printo3d/Prusai3-Rework-Alu/prusai3al-instrukcja.pdf

Prusa i3 - Instrukcja Montażu

1

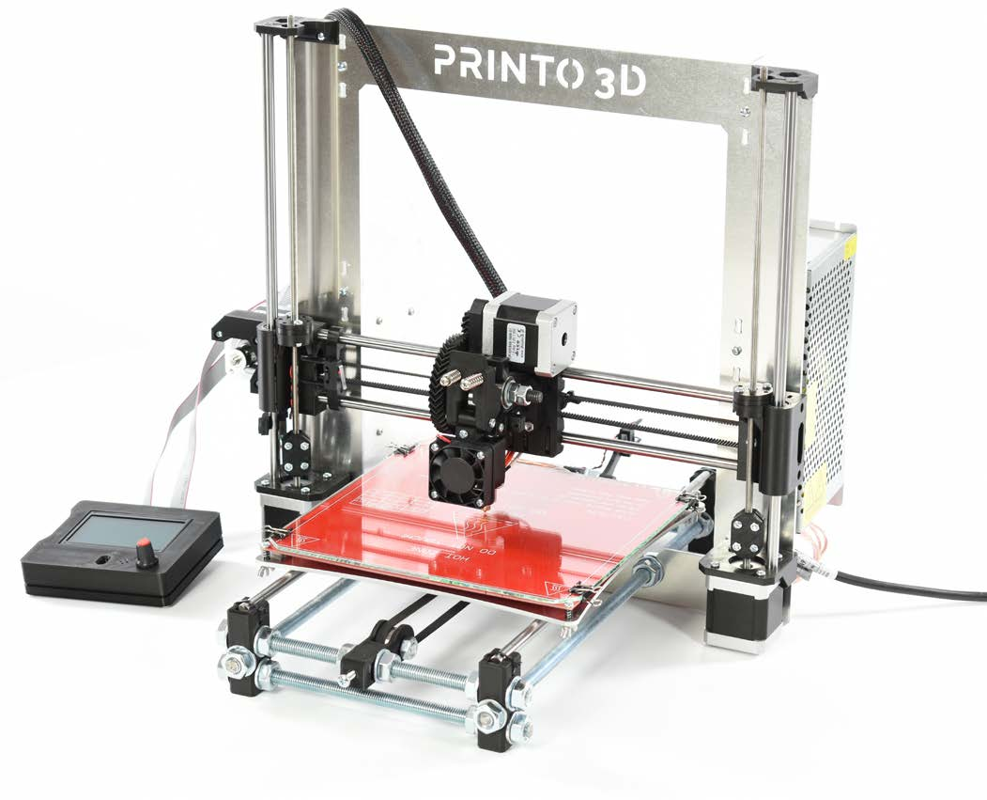
[picture p1: figure]

# Prusa i3

# INSTRUKCJA MONTAŻU DRUKARKI 3D

2

## Spis Treści I. Prusa i3 - Rzut ogólny

4

## II. Lista części

7
III. Montaż | 12
A. Monta
ż osi Y: | 12
1.
Stolik osi Y: | 12
2. Y
Idler | 13
3. Podstawa Y | 13
4.
Silnik osi Y | 16
5. P
asek osi Y | 19
B. Monta
ż osi X: | 22
1. Łoż
ysk

a liniowe - Xend

y | 22
2. Mocowani
a

n

akrętek M5 | 23
3.
K
aretk
a osi X | 24
4. Prowadnice liniowe X | 25
5.
Silnik osi X | 26
6. P
asek osi X | 27
C. Monta
ż

ramy druk

arki

: | 30

D.
O
ś Z | 31
1. Z
botto
m | 31
2. Łąc
zniki osi Z | 33
3. P
o

łąc

zenie osi X

z osią Z | 34
E. Łąc
znie
z osią Y | 37
E. Monta
ż ekstruder | 39
1.
Ekstruder | 39
2. G
łowic

a druk

arki | 40
3.
Went
y

l

ator ch

łod

ząc

y głowicę | 42
4.
Silnik ekstruder
a | 43
V. Elektronika | 47
A. P
rzygotowanie wią

zki
p

r

zewodów | 47
1. P
r

zewod

y silników (
t

ylko wersj

a Prus
a
i3 B) | 47
2. P
r

zewod

y kr

ańcówek (endsto

pów)
i głowic
y | 48
3. Monta
ż kr
ańcówek | 49
4. G
rzał

k

a sto
ł
u | 52
V. Przygotowanie Do Pracy | 59
A.
W
g

r
y

wanie Fir
m
ware | 59
B. P
o

zio

mowanie

Sto
ł
u | 60

3

# I Rzut Ogólny

4

## I. Prusa i3 - Rzut ogólny

Prusa i3 jest wersją otwartego projektu Prusa Mendel autorstwa Josefa Prusy. Wersja przedstawiona w tej instrukcji jest wersją lekko zmodyfikowaną nie odbiegającą jednak od fundamentalnych założeń projektu. Drukarka 3D oparta jest o konstrukcję z 3 mm aluminium, pręty gwintowane M10, prowadnice liniowe fi 8 hartowane indukcyjnie w tolerancji H6 oraz silniki krokowe w standardzie NEMA 17. Wszystkie komponenty użyte do budowy urządzenia są popularne i szeroko dostępne.

Poniższa ilustracja przedstawia kierunki osi XYZ na modelu drukarki 3D Prusa i3

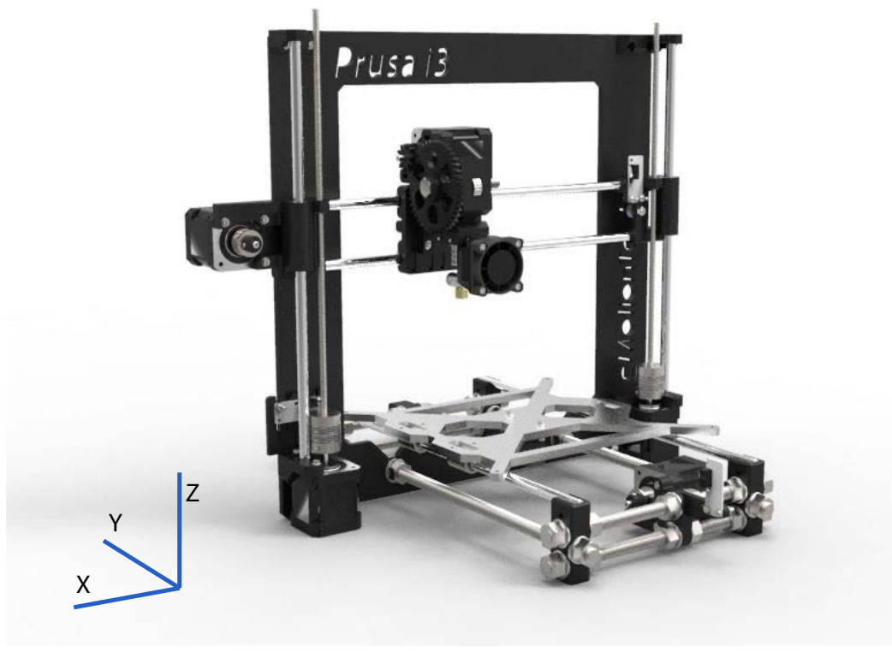
[picture p2: figure]

5

## Przydatne narzędzia

Poniżej lista kilku narzędzi przydatnych do montażu drukarki. Nie wszystkie są wymagane jednak posiadanie ich znacznie ułatwia i przyspiesza pracę nad urządzeniem. Większość z nich jest dostępna w każdym sklepie elektronicznym lub w sieci.
1. Klucze imbusowe
2. Śrubokręt/wkrętak
3. Klucz
4. Nożyk
5. Izolacja/rurki termokurczliwe
6. Multimeter - uniwersalny miernik elektroniczny
7. Lutownica
8. Olej maszynowy do prowadnic
9. Zaciskarka do pinów (budżetowe wersje Prusy i3)
10. Cążki do przewodów

6

# SKŁAD ZESTAWU II

## II. Lista części

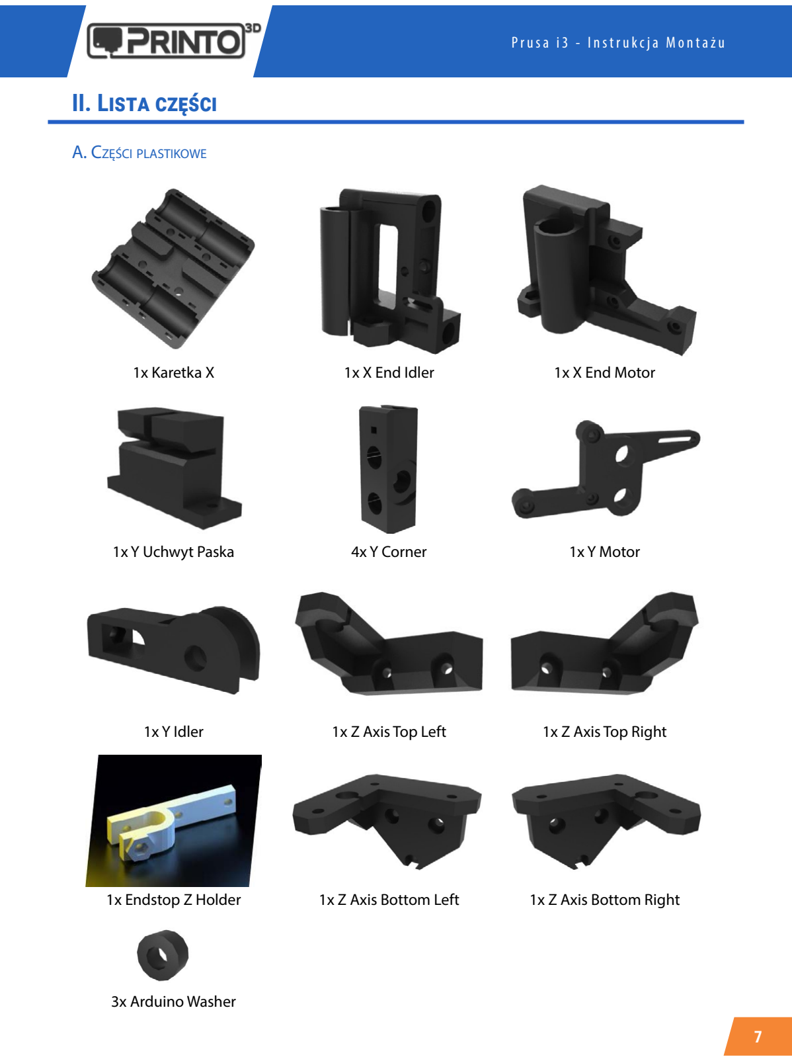
[picture p3: page 7]

7

1x Karetka X | 1x X End Idler | 1x X End Motor
1x Y Uchwyt Paska | 4x Y Corner | 1x Y Motor
1x Y Idler | 1x Z Axis Top Left | 1x Z Axis Top Right

3x Arduino Washer

1x Endstop Z Holder | 1x Z Axis Bottom Left | 1x Z Axis Bottom Right
A. Części plastikowe

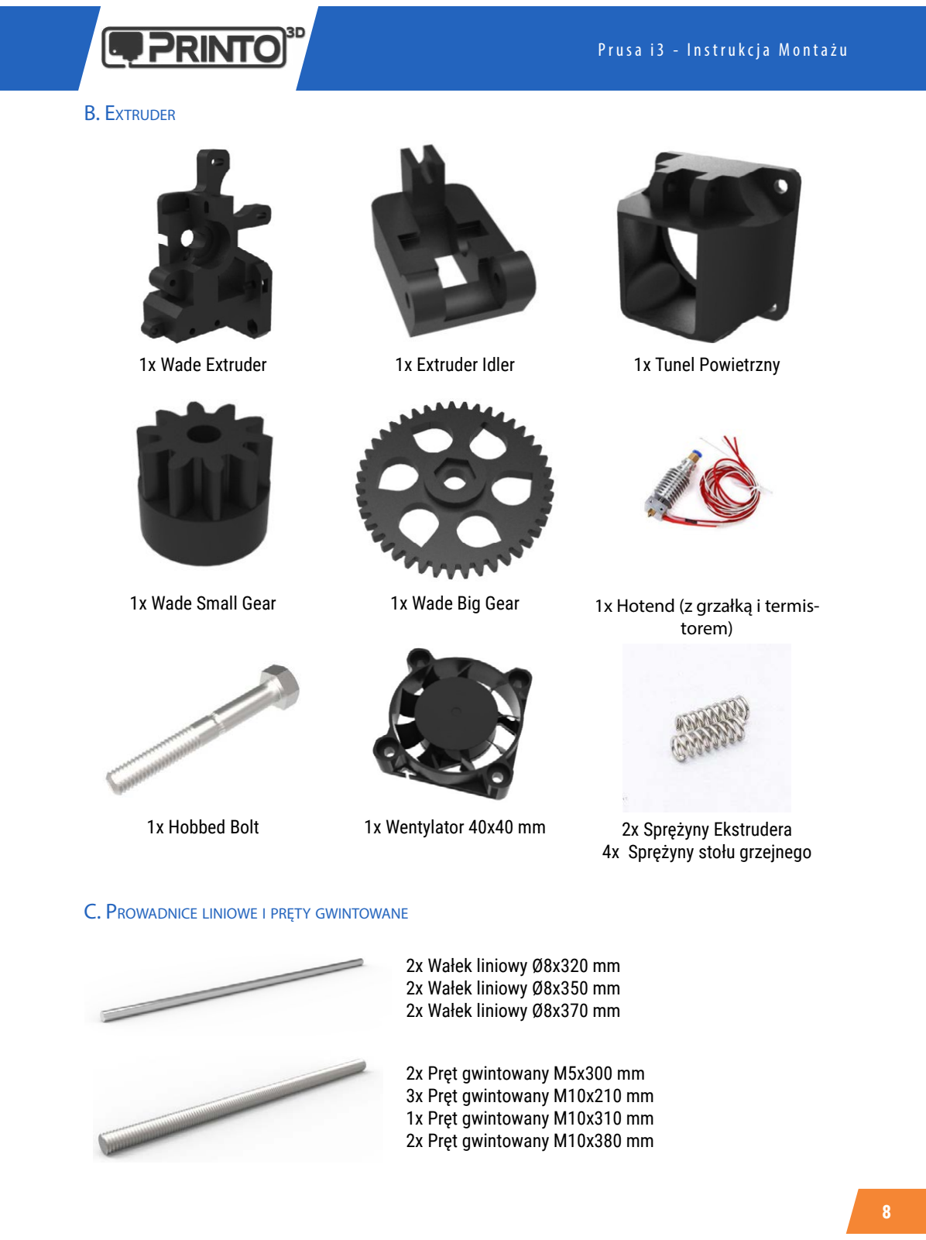
[picture p4: page 8]

8

1x Wade Extruder | 1x Extruder Idler | 1x Tunel Powietrzny
1x Wade Small Gear | 1x Wade Big Gear | 1x Hotend (z grzałką i termis- torem)
C. Prowadnice liniowe i pręty gwintowane

2x Pręt gwintowany M5x300 mm 3x Pręt gwintowany M10x210 mm 1x Pręt gwintowany M10x310 mm 2x Pręt gwintowany M10x380 mm

B. Extruder
1x Hobbed Bolt | 1x Wentylator 40x40 mm | 2x Sprężyny Ekstrudera 4x Sprężyny stołu grzejnego

2x Wałek liniowy Ø8x320 mm 2x Wałek liniowy Ø8x350 mm 2x Wałek liniowy Ø8x370 mm

9

D. Części mechaniczne

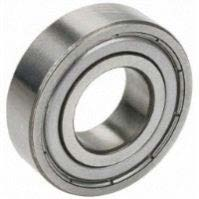
[picture p5: figure]
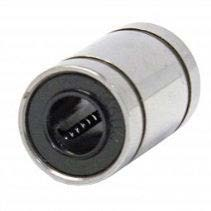
[picture p6: figure]
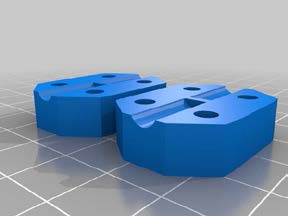
[picture p7: figure]

11x LM8UU łożysko liniowe | 1x Łożysko kulowe 624ZZ 4x Łożysko kulowe 608ZZ
2x Sprzęgło 5*5

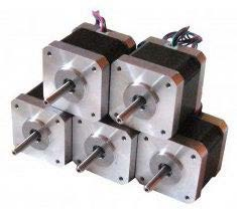
[picture p8: figure]
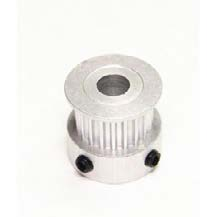
[picture p9: figure]
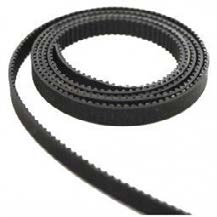
[picture p10: figure]

5x silniki NEMA 17 | 1x GT2 pasek (760 mm)
1x GT2 pasek (900 mm) 2x GT2 zębatka
E. Stół grzejny

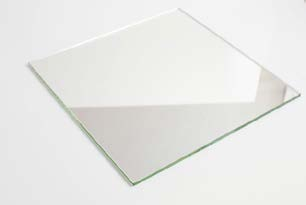
[picture p11: figure]
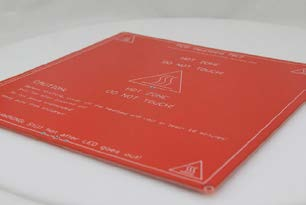
[picture p12: figure]

1x MK2B | 1x Szyba 20 x 20cm

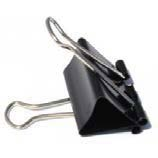
[picture p13: figure]

4x Klips biurowy

1x Termistor

10

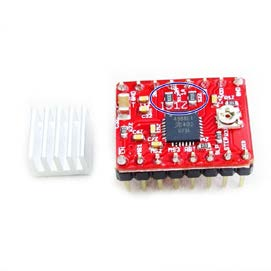
[picture p14: figure]
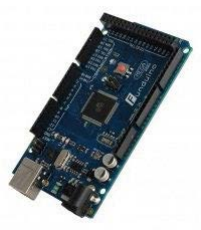
[picture p15: figure]
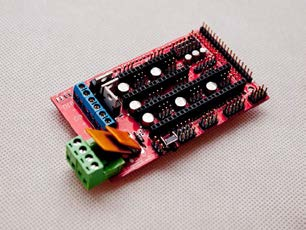
[picture p16: figure]

1x RAMPS 1.4 | 1x Atmega 2560 | 4x Stepstick

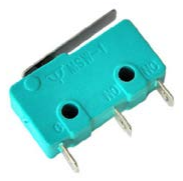
[picture p17: figure]
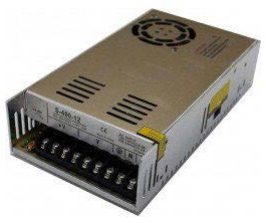
[picture p18: figure]

3x Krańcówki | 1x Zasilacz 12V 16A
F. Elektronika
G. Śruby, nakrętki i podkladki

3x10 15 szt
3x14 30 szt
3x20 6 szt
3x25 6 szt
3x30 7 szt
3x50 2 szt
4x20 6 szt
8x30 1 szt
8x20 bez łba
M3 | 50 szt
M8 | 6 szt
M10 40 szt
M3 | 45 szt
M4 | 8 szt
M5 | 2 szt
M8 | 4 szt
M10 40 szt

11

# III Montaż

## III. Montaż

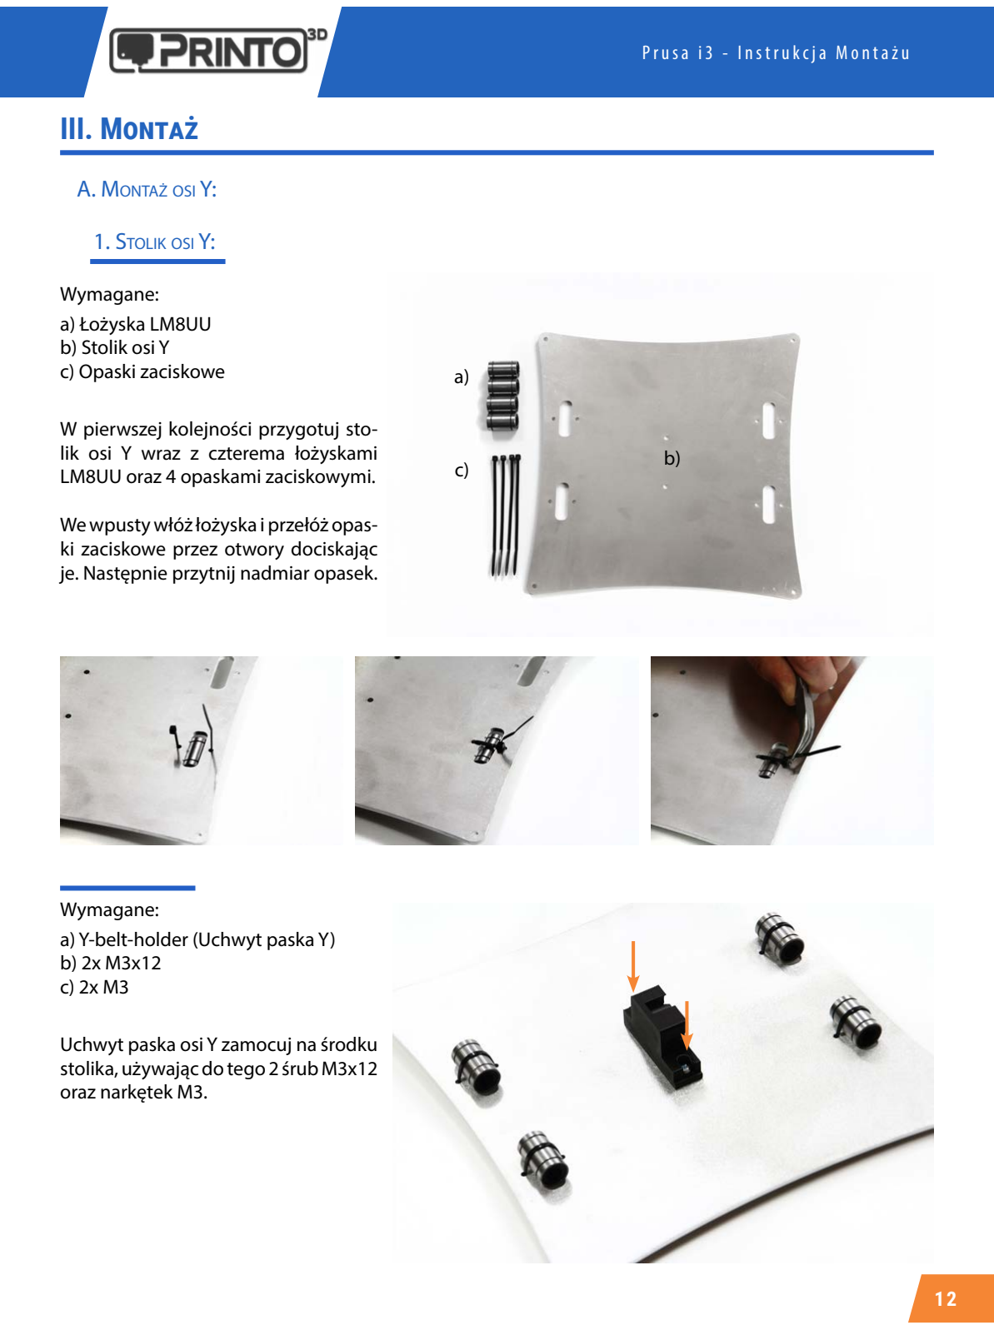
[picture p19: page 12]

12

A. Montaż osi Y:

Uchwyt paska osi Y zamocuj na środku stolika, używając do tego 2 śrub M3x12 oraz narkętek M3.

1. Stolik osi Y:

W pierwszej kolejności przygotuj stolik osi Y wraz z czterema łożyskami LM8UU oraz 4 opaskami zaciskowymi.

We wpusty włóż łożyska i przełóż opaski zaciskowe przez otwory dociskając je. Następnie przytnij nadmiar opasek.

Wymagane:
a) Łożyska LM8UU
b) Stolik osi Y
c) Opaski zaciskowe | a)
c) b)

Wymagane:
a) Y-belt-holder (Uchwyt paska Y)
b) 2x M3x12
c) 2x M3

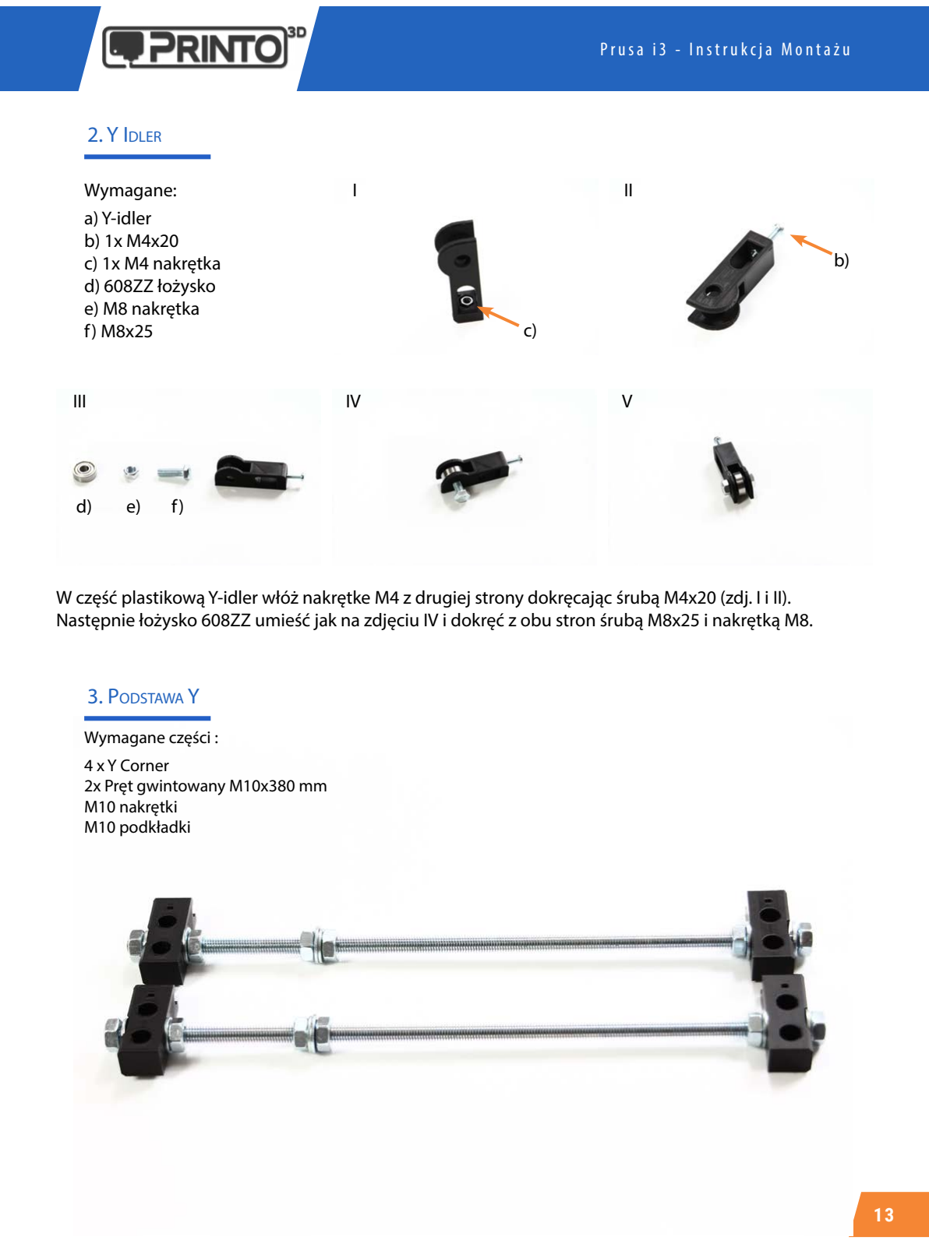
[picture p20: page 13]

13

2. Y Idler
3. Podstawa Y

Wymagane części :
4 x Y Corner
2x Pręt gwintowany M10x380 mm M10 nakrętki
M10 podkładki

W część plastikową Y-idler włóż nakrętke M4 z drugiej strony dokręcając śrubą M4x20 (zdj. I i II). Następnie łożysko 608ZZ umieść jak na zdjęciu IV i dokręć z obu stron śrubą M8x25 i nakrętką M8.

I | II
III | IV | V

Wymagane:
a) Y-idler
b) 1x M4x20
c) 1x M4 nakrętka
d) 608ZZ łożysko
e) M8 nakrętka
f) M8x25

b)

c)

d) | e) | f)

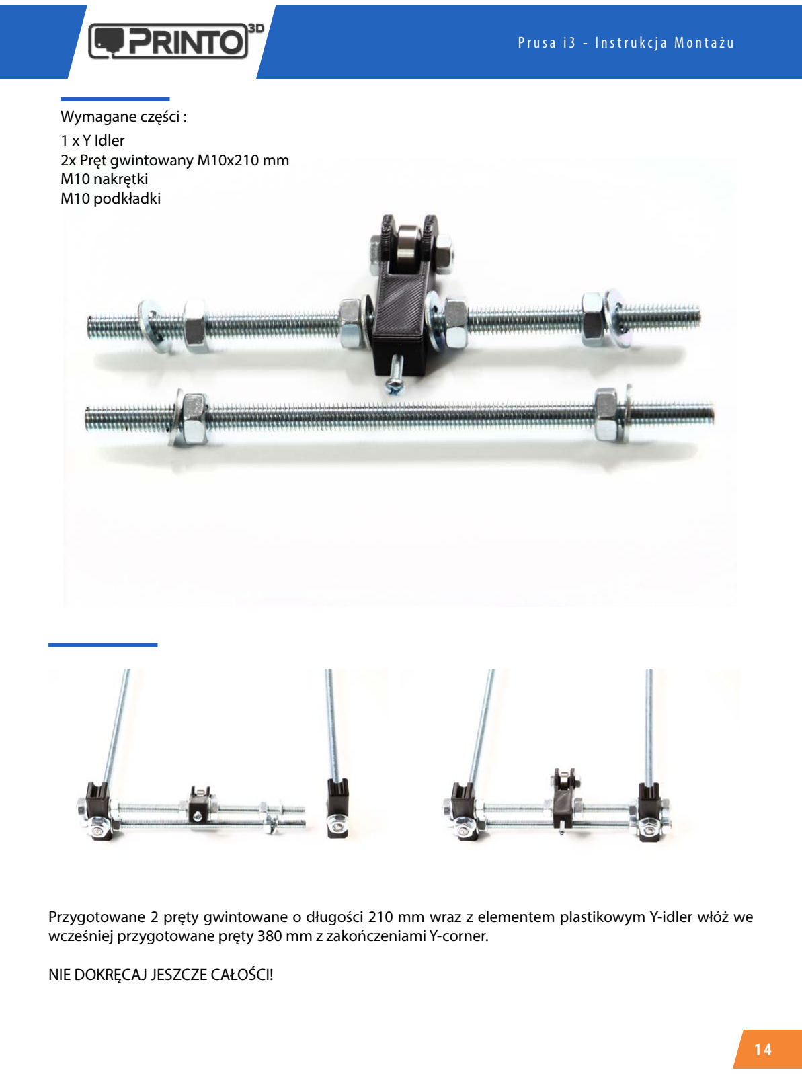
[picture p21: page 14]

14

Wymagane części :
1 x Y Idler
2x Pręt gwintowany M10x210 mm M10 nakrętki
M10 podkładki

Przygotowane 2 pręty gwintowane o długości 210 mm wraz z elementem plastikowym Y-idler włóż we wcześniej przygotowane pręty 380 mm z zakończeniami Y-corner.

NIE DOKRĘCAJ JESZCZE CAŁOŚCI!

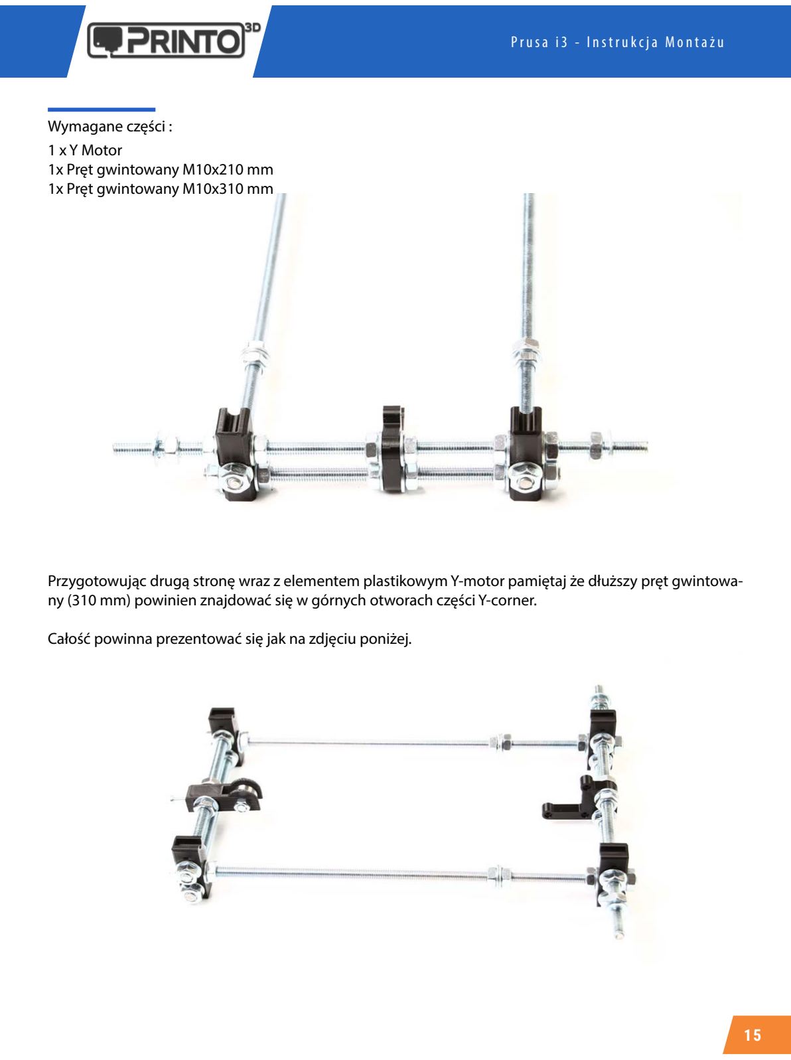
[picture p22: page 15]

15

Przygotowując drugą stronę wraz z elementem plastikowym Y-motor pamiętaj że dłuższy pręt gwintowany (310 mm) powinien znajdować się w górnych otworach części Y-corner.

Całość powinna prezentować się jak na zdjęciu poniżej.

Wymagane części :
1 x Y Motor
1x Pręt gwintowany M10x210 mm 1x Pręt gwintowany M10x310 mm

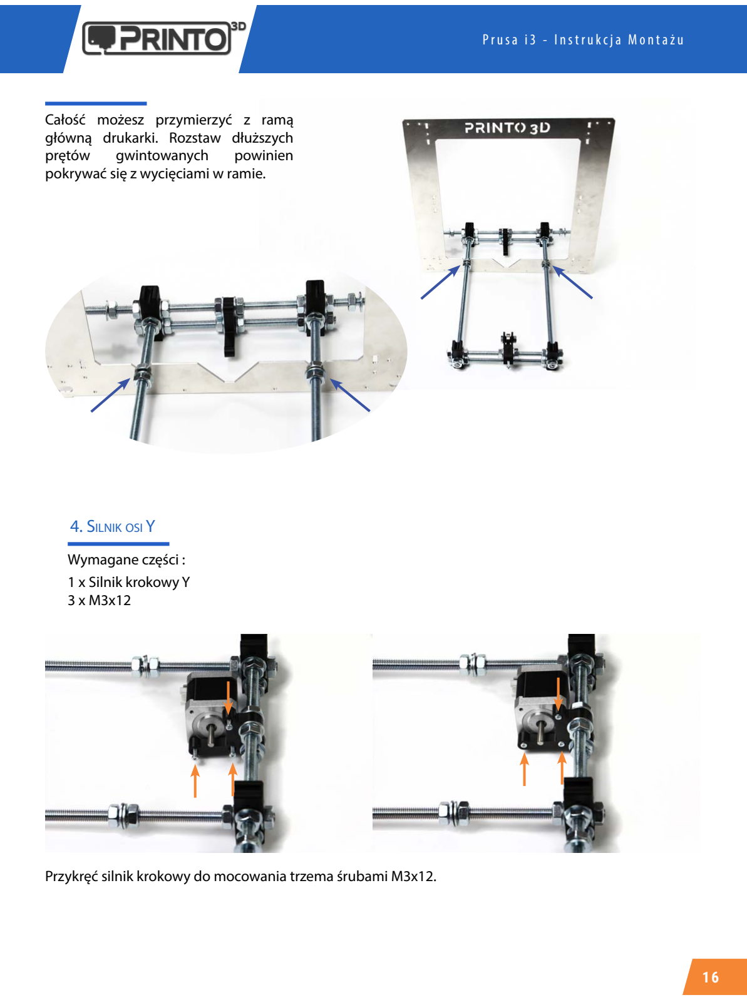
[picture p23: page 16]

16

Całość możesz przymierzyć z ramą główną drukarki. Rozstaw dłuższych
prętów | gwintowanych | powinien
pokrywać się z wycięciami w ramie.
4. Silnik osi Y

Wymagane części :
1 x Silnik krokowy Y
3 x M3x12

Przykręć silnik krokowy do mocowania trzema śrubami M3x12.

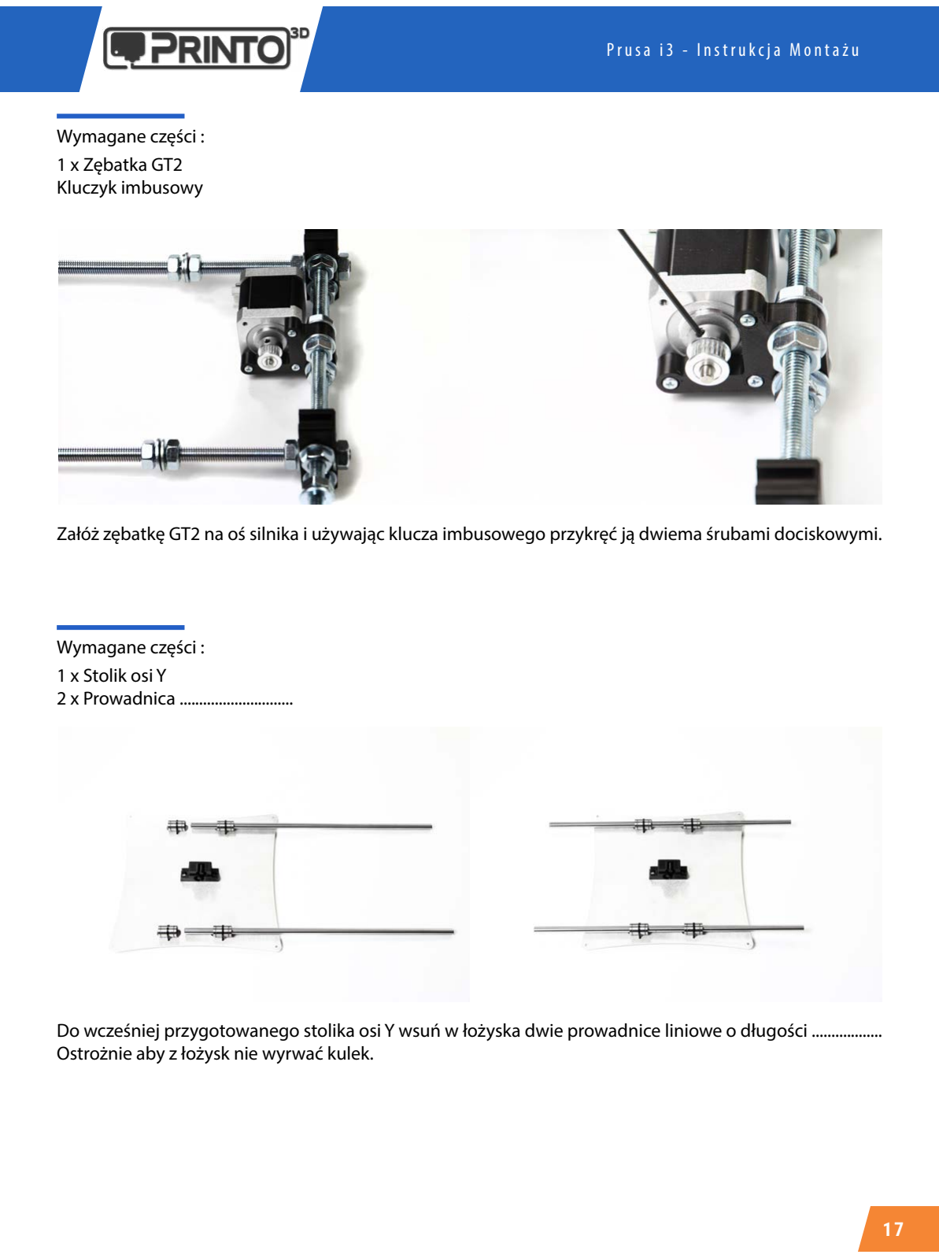
[picture p24: page 17]

17

Wymagane części :
1 x Zębatka GT2
Kluczyk imbusowy

Załóż zębatkę GT2 na oś silnika i używając klucza imbusowego przykręć ją dwiema śrubami dociskowymi.

Wymagane części :
1 x Stolik osi Y
2 x Prowadnica |
Do wcześniej przygotowanego stolika osi Y wsuń w łożyska dwie prowadnice liniowe o długości |
Ostrożnie aby z łożysk nie wyrwać kulek.

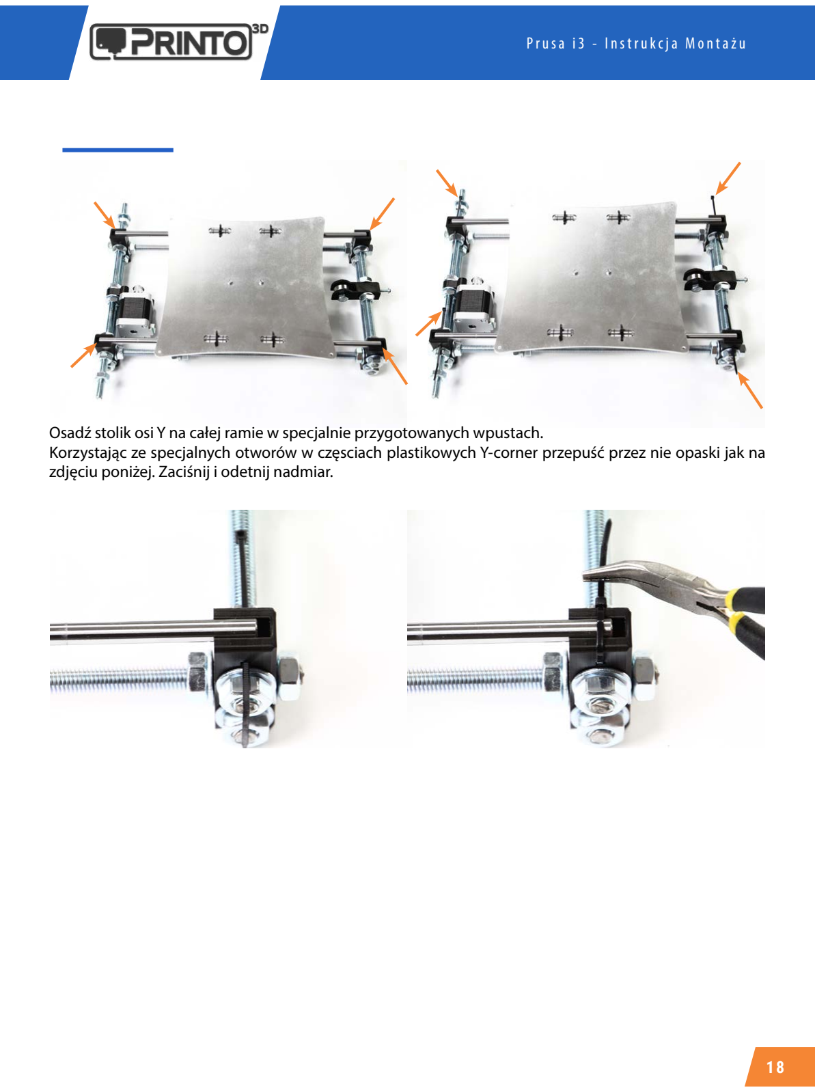
[picture p25: page 18]

18

Osadź stolik osi Y na całej ramie w specjalnie przygotowanych wpustach.
Korzystając ze specjalnych otworów w częsciach plastikowych Y-corner przepuść przez nie opaski jak na zdjęciu poniżej. Zaciśnij i odetnij nadmiar.

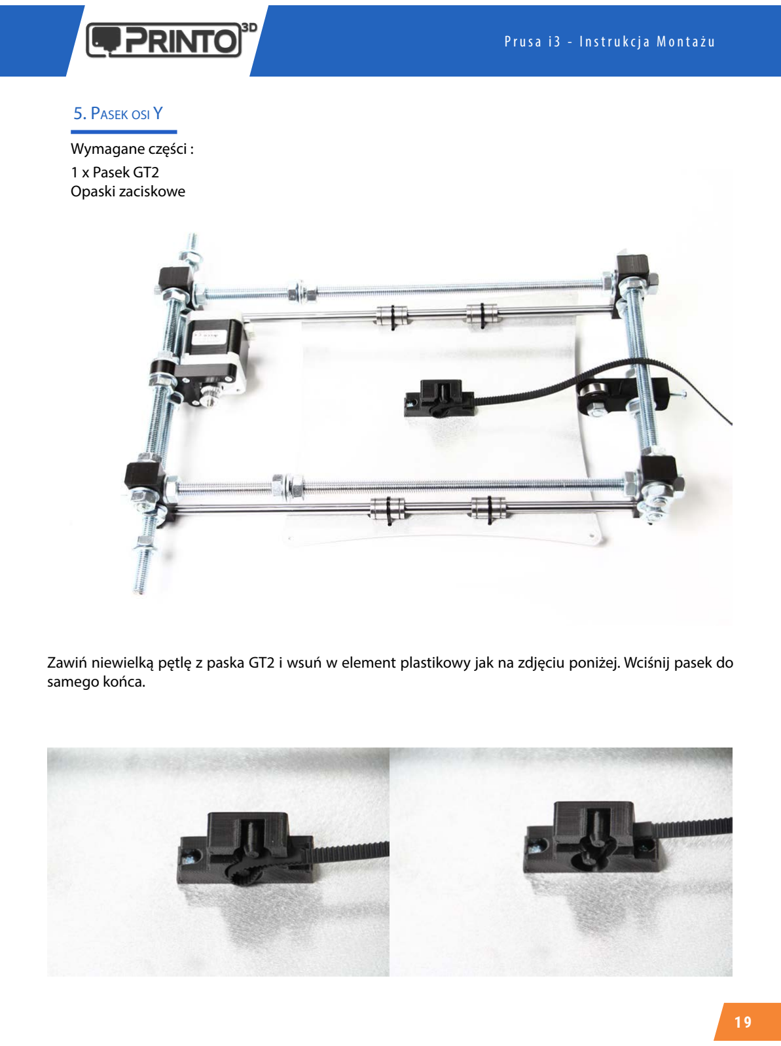
[picture p26: page 19]

19

5. Pasek osi Y

Wymagane części :
1 x Pasek GT2
Opaski zaciskowe

Zawiń niewielką pętlę z paska GT2 i wsuń w element plastikowy jak na zdjęciu poniżej. Wciśnij pasek do samego końca.

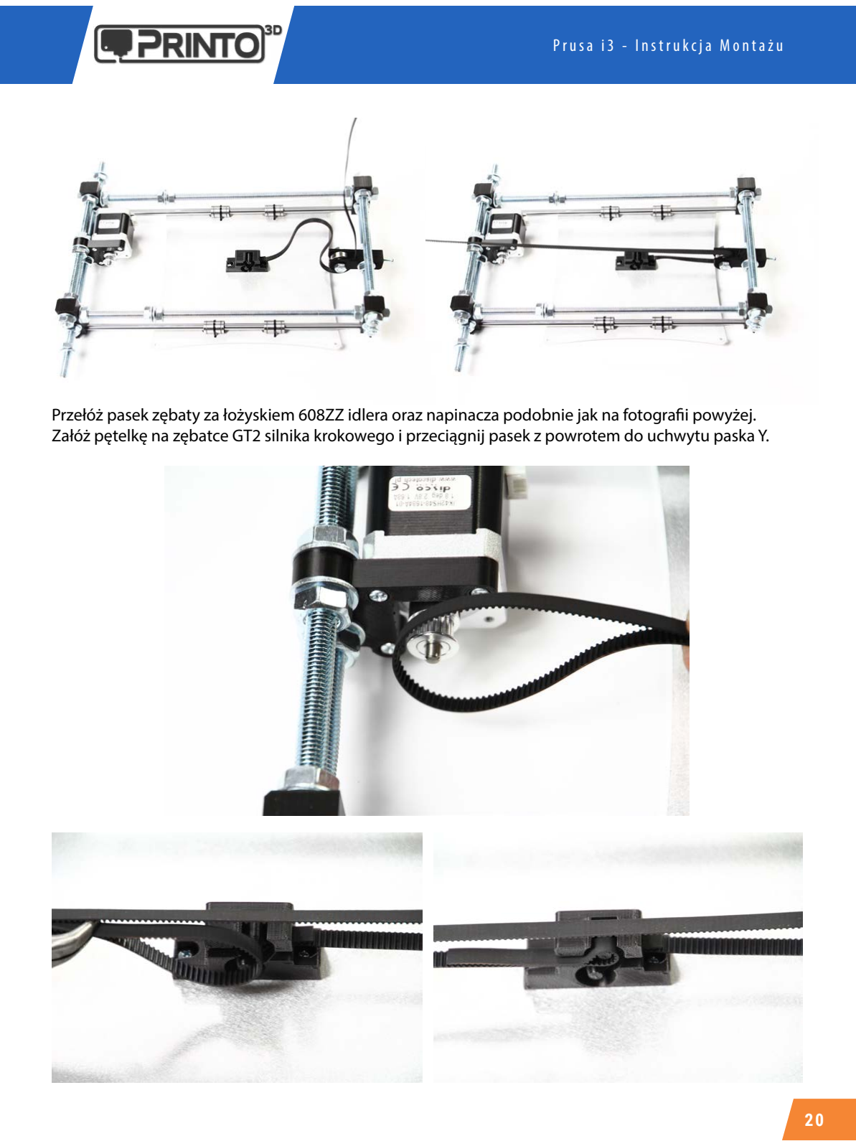
[picture p27: page 20]

20

Przełóż pasek zębaty za łożyskiem 608ZZ idlera oraz napinacza podobnie jak na fotografii powyżej. Załóż pętelkę na zębatce GT2 silnika krokowego i przeciągnij pasek z powrotem do uchwytu paska Y.

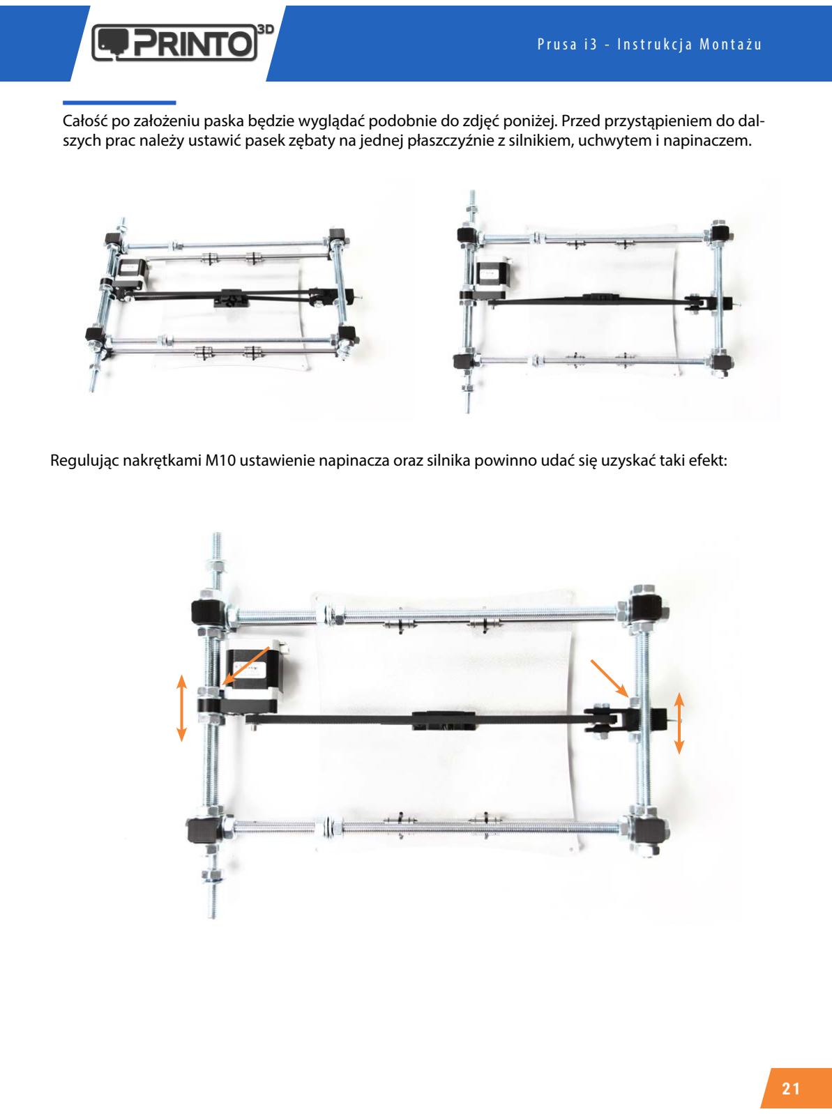
[picture p28: page 21]

21

Całość po założeniu paska będzie wyglądać podobnie do zdjęć poniżej. Przed przystąpieniem do dalszych prac należy ustawić pasek zębaty na jednej płaszczyźnie z silnikiem, uchwytem i napinaczem.

Regulując nakrętkami M10 ustawienie napinacza oraz silnika powinno udać się uzyskać taki efekt:

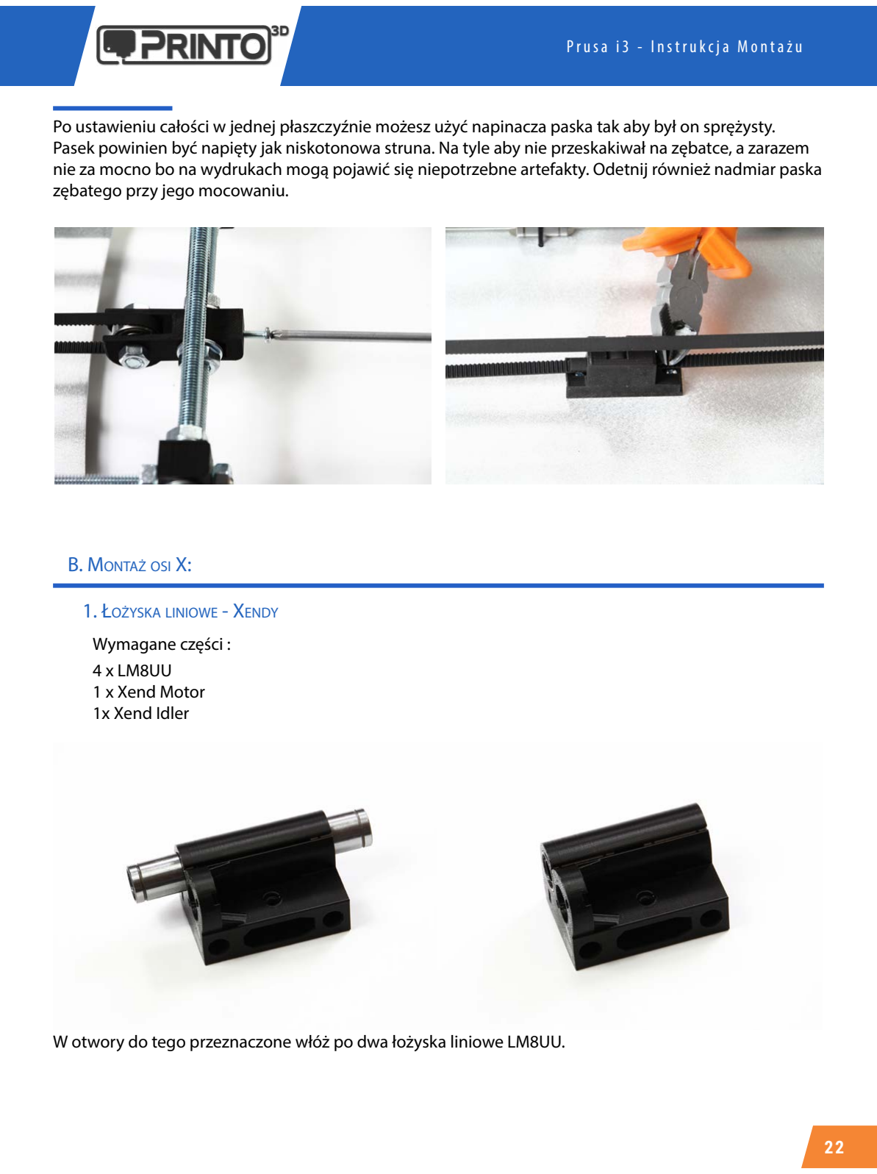
[picture p29: page 22]

22

Po ustawieniu całości w jednej płaszczyźnie możesz użyć napinacza paska tak aby był on sprężysty. Pasek powinien być napięty jak niskotonowa struna. Na tyle aby nie przeskakiwał na zębatce, a zarazem nie za mocno bo na wydrukach mogą pojawić się niepotrzebne artefakty. Odetnij również nadmiar paska zębatego przy jego mocowaniu.

B. Montaż osi X:
1. Łożyska liniowe - Xendy
Wymagane części :
4 x LM8UU
1 x Xend Motor
1x Xend Idler

W otwory do tego przeznaczone włóż po dwa łożyska liniowe LM8UU.

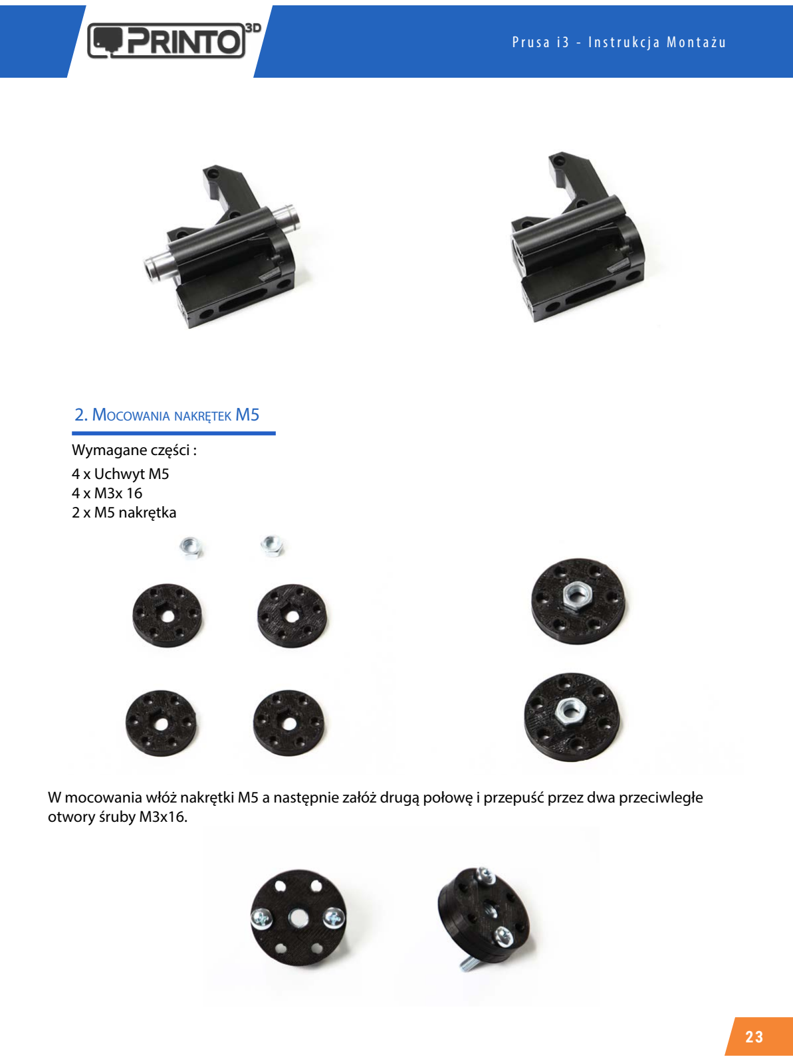
[picture p30: page 23]

23

W mocowania włóż nakrętki M5 a następnie załóż drugą połowę i przepuść przez dwa przeciwległe otwory śruby M3x16.

2. Mocowania nakrętek M5

Wymagane części :
4 x Uchwyt M5
4 x M3x 16
2 x M5 nakrętka

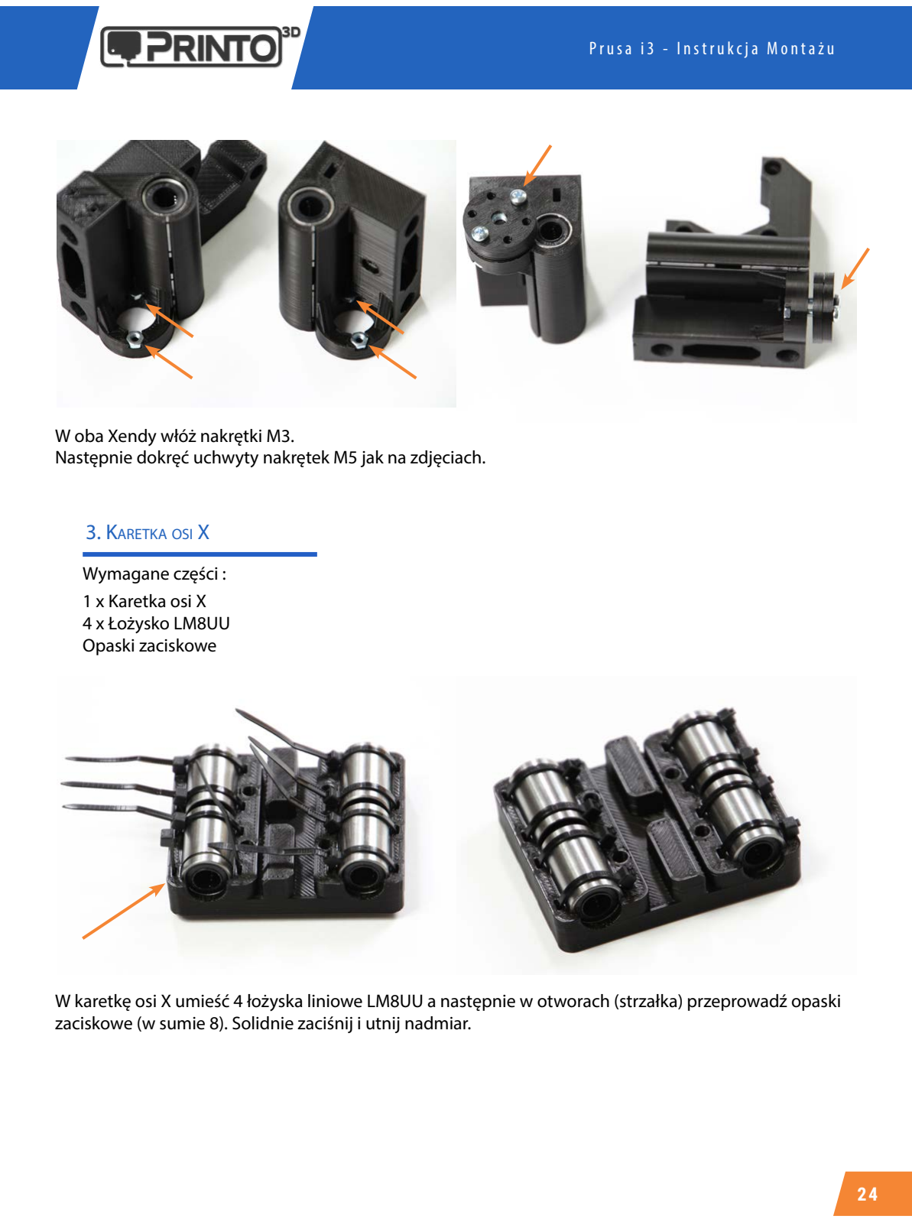
[picture p31: page 24]

24

W oba Xendy włóż nakrętki M3.
Następnie dokręć uchwyty nakrętek M5 jak na zdjęciach.
3. Karetka osi X

Wymagane części :
1 x Karetka osi X
4 x Łożysko LM8UU
Opaski zaciskowe

W karetkę osi X umieść 4 łożyska liniowe LM8UU a następnie w otworach (strzałka) przeprowadź opaski zaciskowe (w sumie 8). Solidnie zaciśnij i utnij nadmiar.

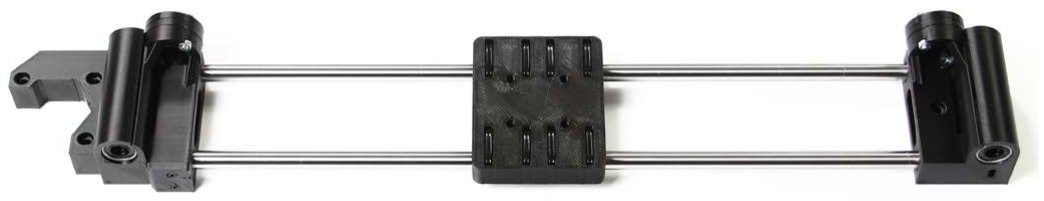
[picture p32: figure]

25

Po upewnieniu się że średnice pasują, umieść w jednym Xendzie prowadnice liniowe, następnie wsuń na nie karetkę osi X. Po wykonaniu tych kroków załóż drugi Xend na prowadnice.

4. Prowadnice liniowe X

Wymagane części :
2 x Prowadnica liniowa 370 mm 1 x Łożysko 624ZZ
1 x M4x20

Przed przystąpieniem do tego kroku bardzo delikatnie spróbuj wsunąć prowadnicę liniową w otwory oznaczone strzałkami. Jeżeli będzie to zbyt cięzkie NIE WCISKAJ ICH NA SIŁĘ!
Z uwagi na technologię w jakiej wykonane są plastiki (FDM) mogą pojawiać się wahania średnicy.

Bardzo ostrożnie rozwierć wiertłem 8 mm otwory, lub wygładź ich powierzchnię małym pilnikiem.

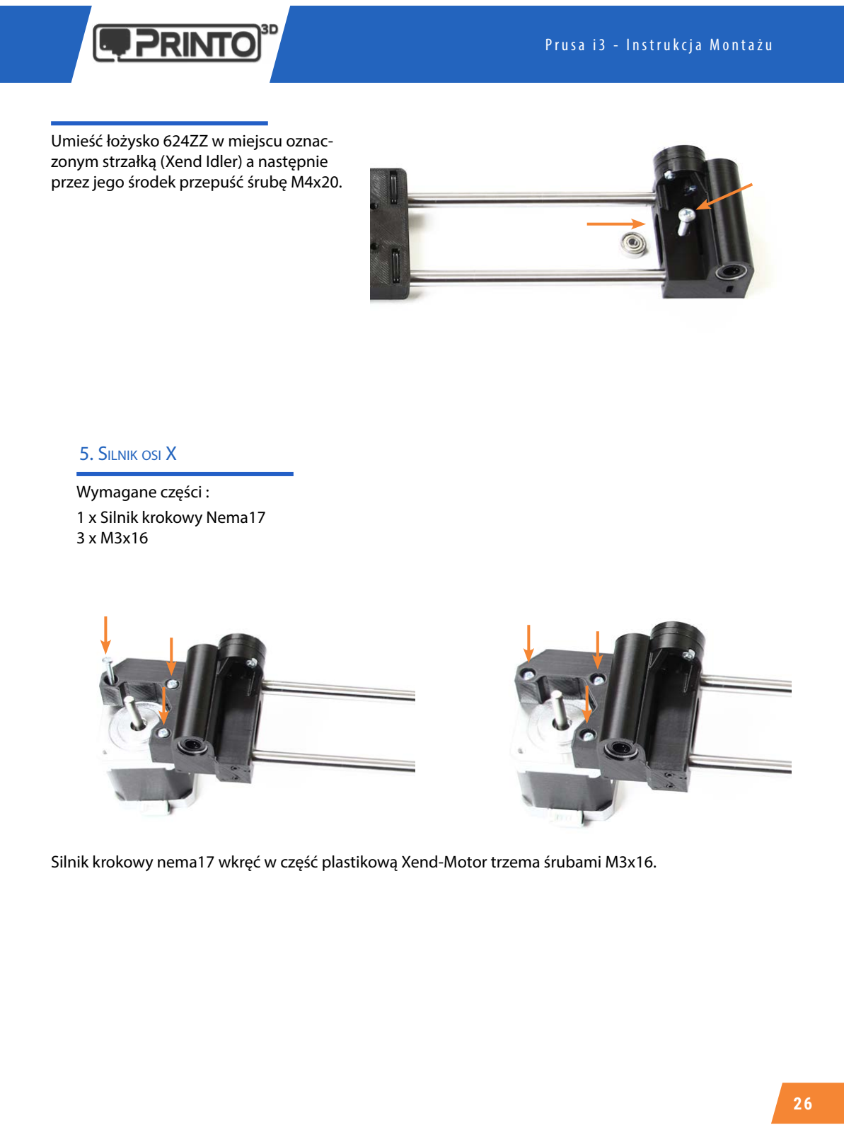
[picture p33: page 26]

26

Umieść łożysko 624ZZ w miejscu oznaczonym strzałką (Xend Idler) a następnie przez jego środek przepuść śrubę M4x20.

5. Silnik osi X

Wymagane części :
1 x Silnik krokowy Nema17
3 x M3x16

Silnik krokowy nema17 wkręć w część plastikową Xend-Motor trzema śrubami M3x16.

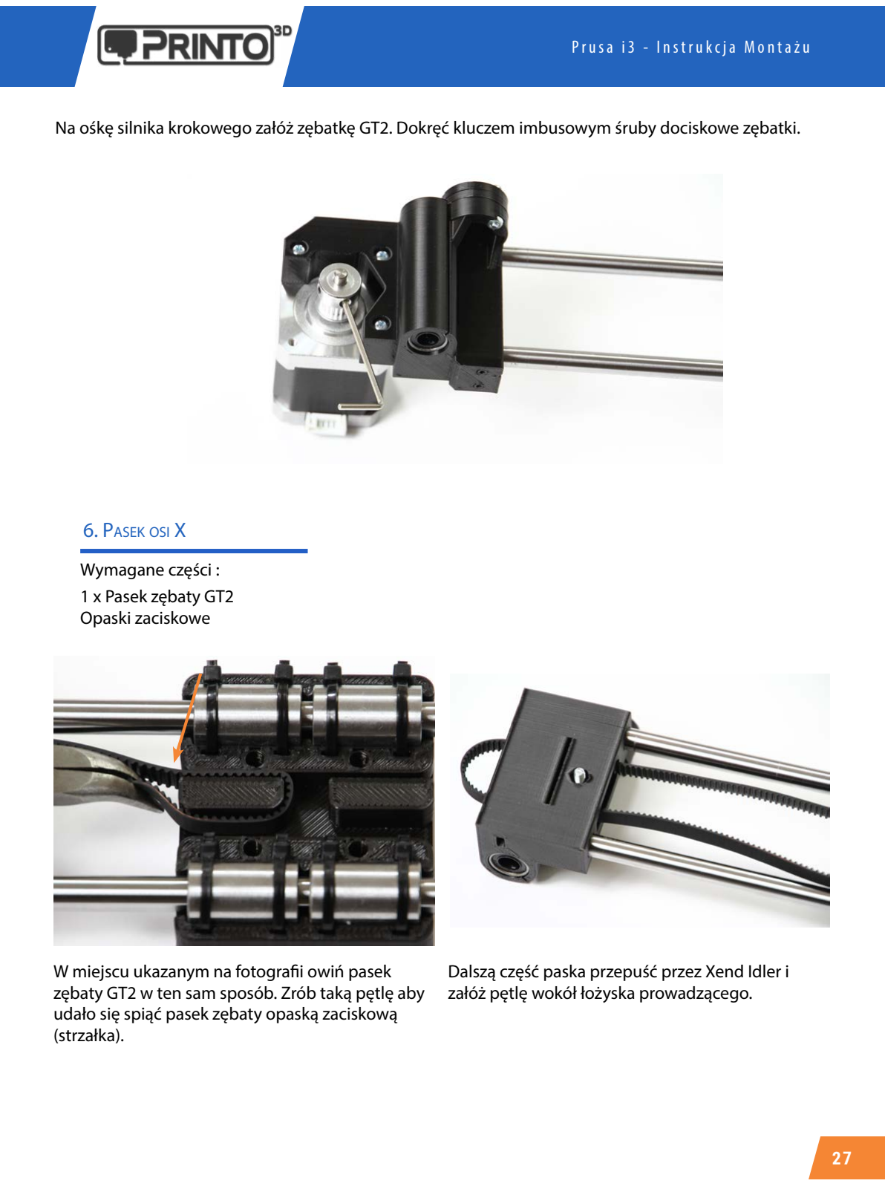
[picture p34: page 27]

27

Na ośkę silnika krokowego załóż zębatkę GT2. Dokręć kluczem imbusowym śruby dociskowe zębatki.

6. Pasek osi X

Wymagane części :
1 x Pasek zębaty GT2
Opaski zaciskowe

W miejscu ukazanym na fotografii owiń pasek zębaty GT2 w ten sam sposób. Zrób taką pętlę aby udało się spiąć pasek zębaty opaską zaciskową (strzałka).

Dalszą część paska przepuść przez Xend Idler i załóż pętlę wokół łożyska prowadzącego.

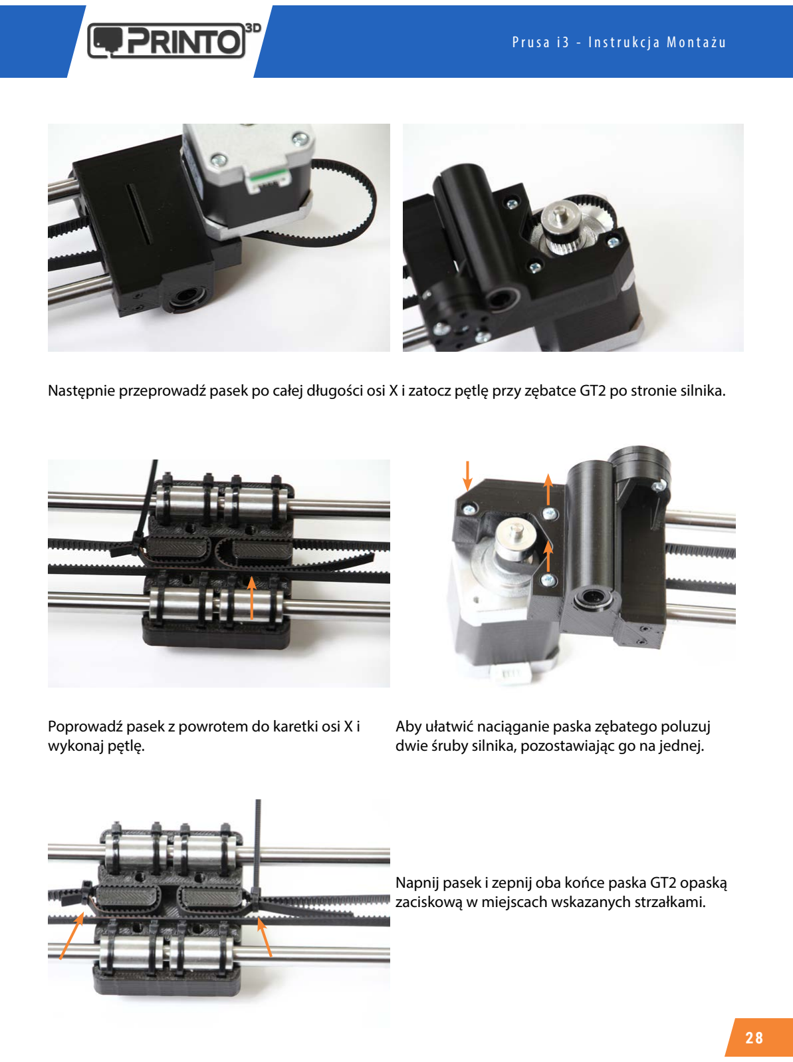
[picture p35: page 28]

28

Następnie przeprowadź pasek po całej długości osi X i zatocz pętlę przy zębatce GT2 po stronie silnika.

Poprowadź pasek z powrotem do karetki osi X i wykonaj pętlę.

Aby ułatwić naciąganie paska zębatego poluzuj dwie śruby silnika, pozostawiając go na jednej.

Napnij pasek i zepnij oba końce paska GT2 opaską zaciskową w miejscach wskazanych strzałkami.

29

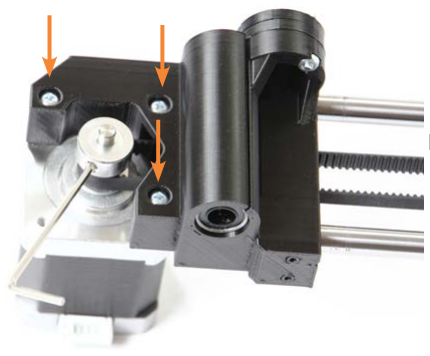
[picture p36: figure]

Dokręć silnik krokowy w całości.

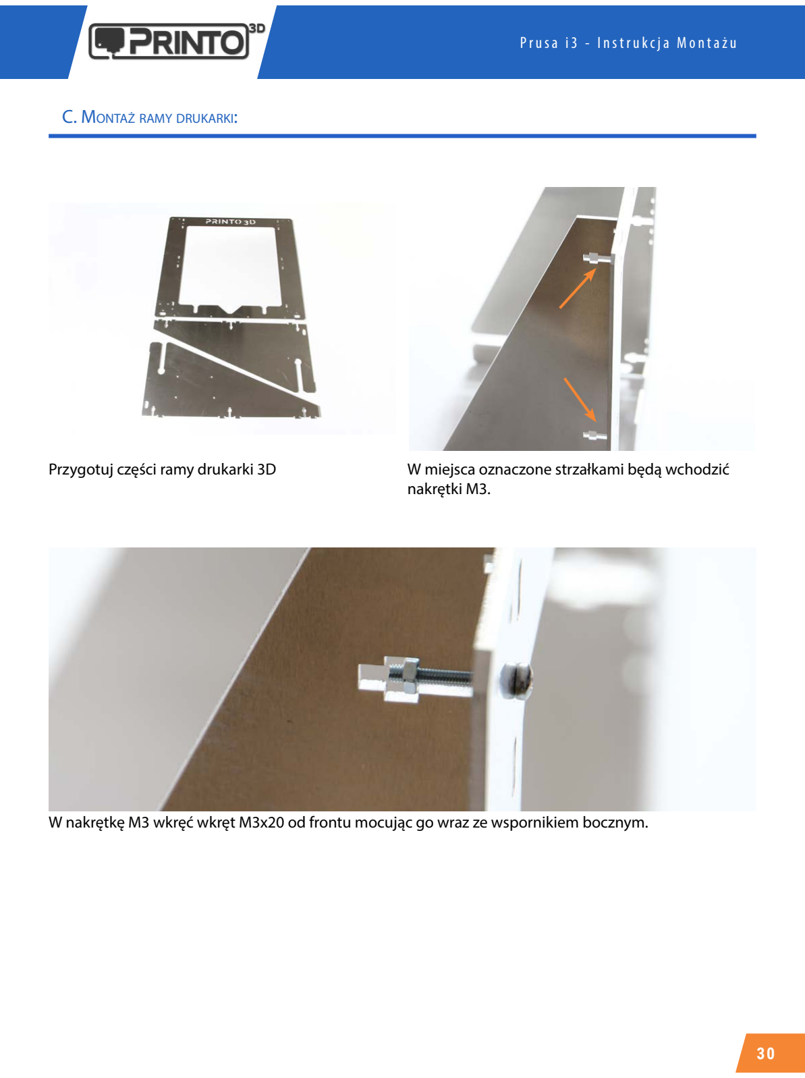
[picture p37: page 30]

30

C. Montaż ramy drukarki:
Przygotuj części ramy drukarki 3D | W miejsca oznaczone strzałkami będą wchodzić nakrętki M3.

W nakrętkę M3 wkręć wkręt M3x20 od frontu mocując go wraz ze wspornikiem bocznym.

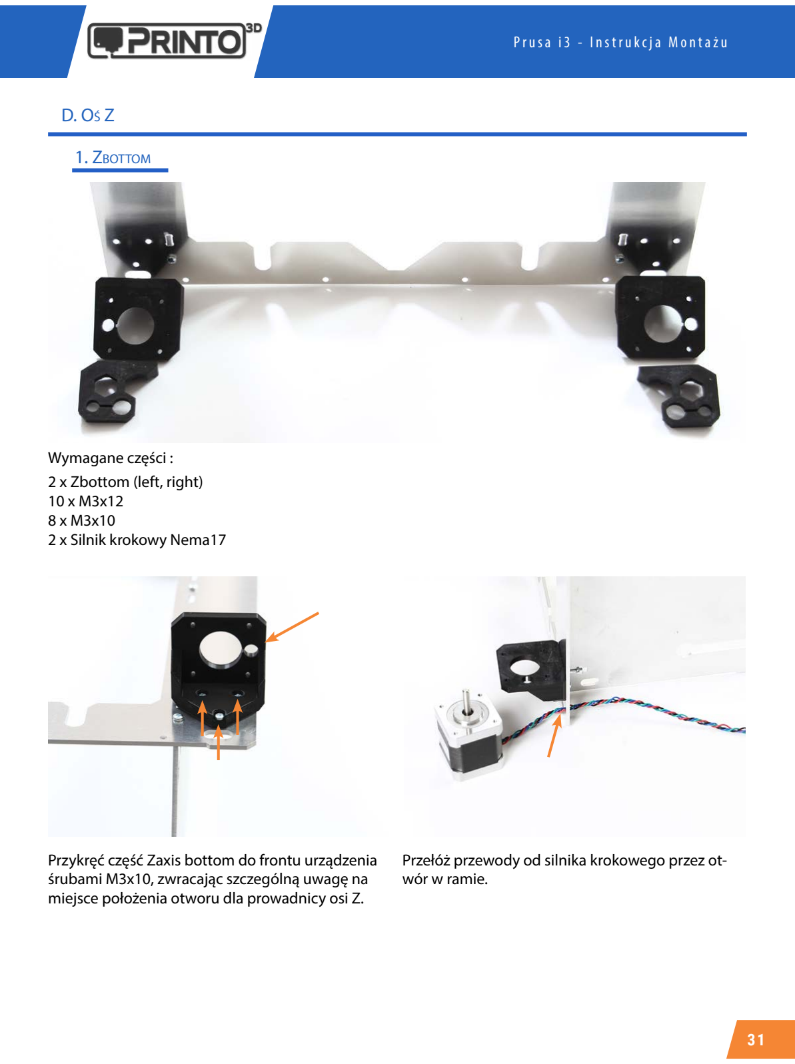
[picture p38: page 31]

31

D. Oś Z
1. Zbottom

Wymagane części :
2 x Zbottom (left, right)
10 x M3x12
8 x M3x10
2 x Silnik krokowy Nema17

Przykręć część Zaxis bottom do frontu urządzenia śrubami M3x10, zwracając szczególną uwagę na miejsce położenia otworu dla prowadnicy osi Z.

Przełóż przewody od silnika krokowego przez otwór w ramie.

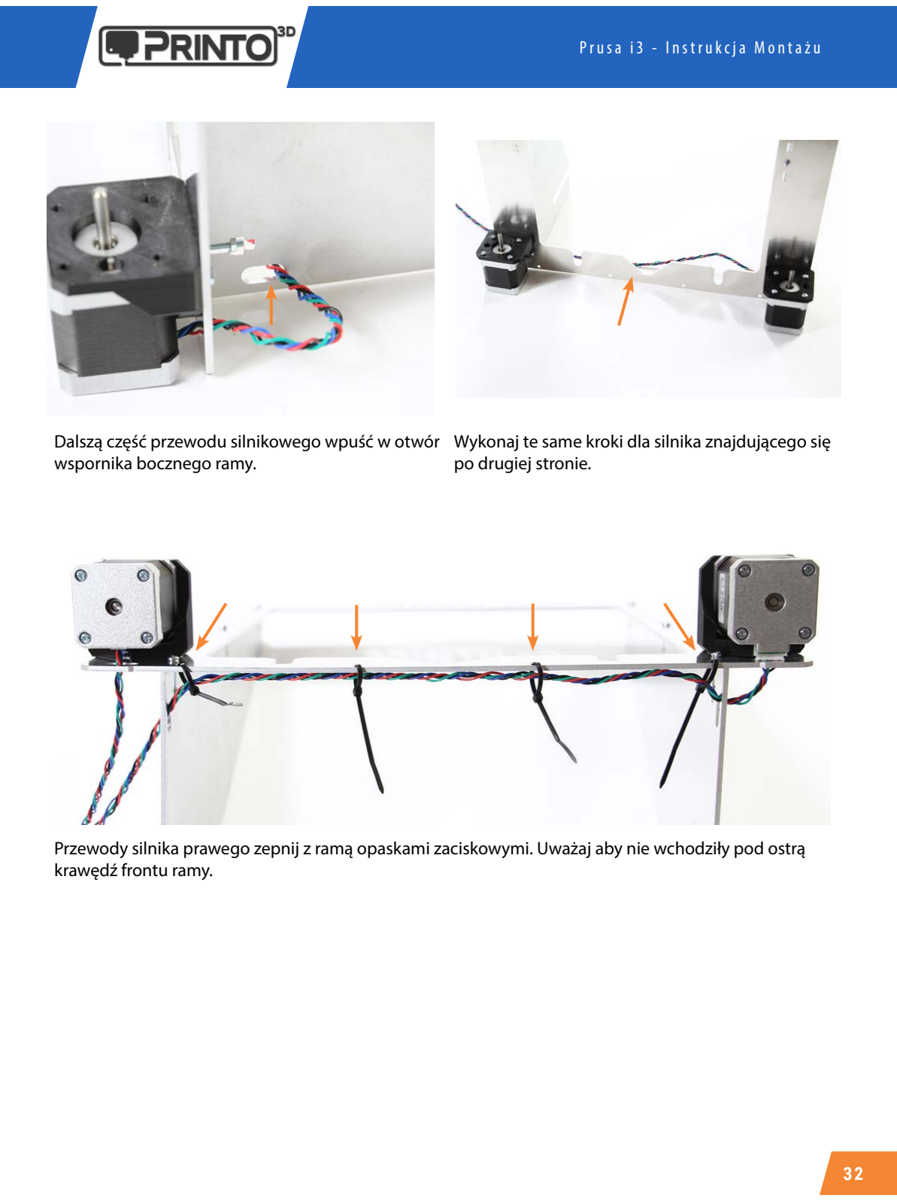
[picture p39: page 32]

32

Dalszą część przewodu silnikowego wpuść w otwór wspornika bocznego ramy.

Wykonaj te same kroki dla silnika znajdującego się po drugiej stronie.

Przewody silnika prawego zepnij z ramą opaskami zaciskowymi. Uważaj aby nie wchodziły pod ostrą krawędź frontu ramy.

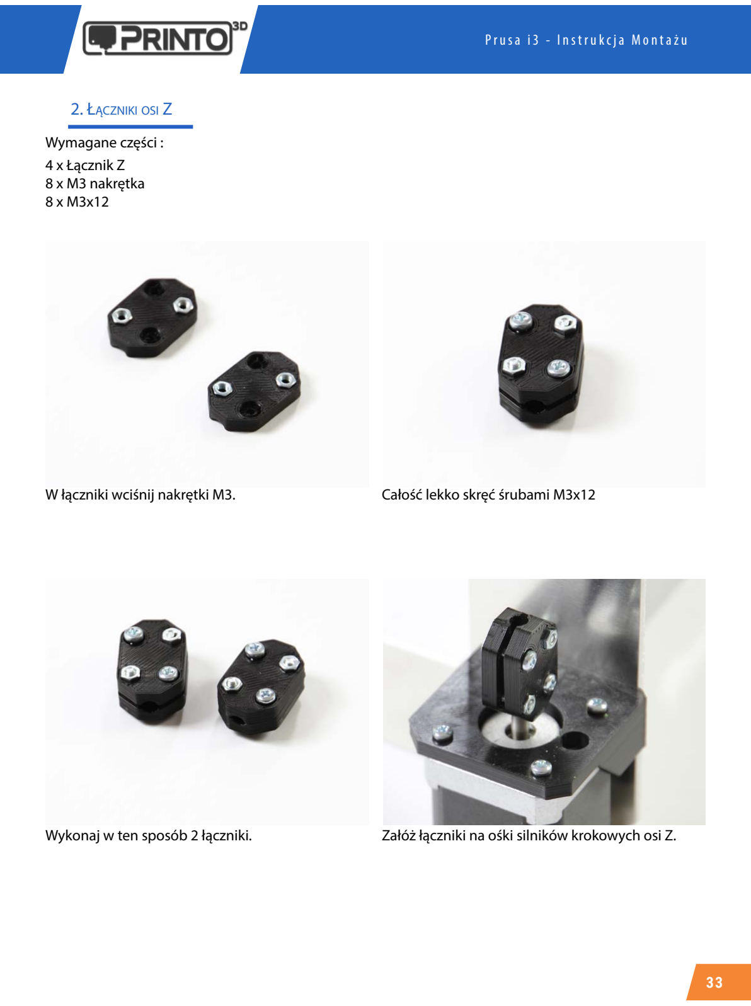
[picture p40: page 33]

33

2. Łączniki osi Z
W łączniki wciśnij nakrętki M3. | Całość lekko skręć śrubami M3x12

Wymagane części :
4 x Łącznik Z
8 x M3 nakrętka
8 x M3x12
Wykonaj w ten sposób 2 łączniki. | Załóż łączniki na ośki silników krokowych osi Z.

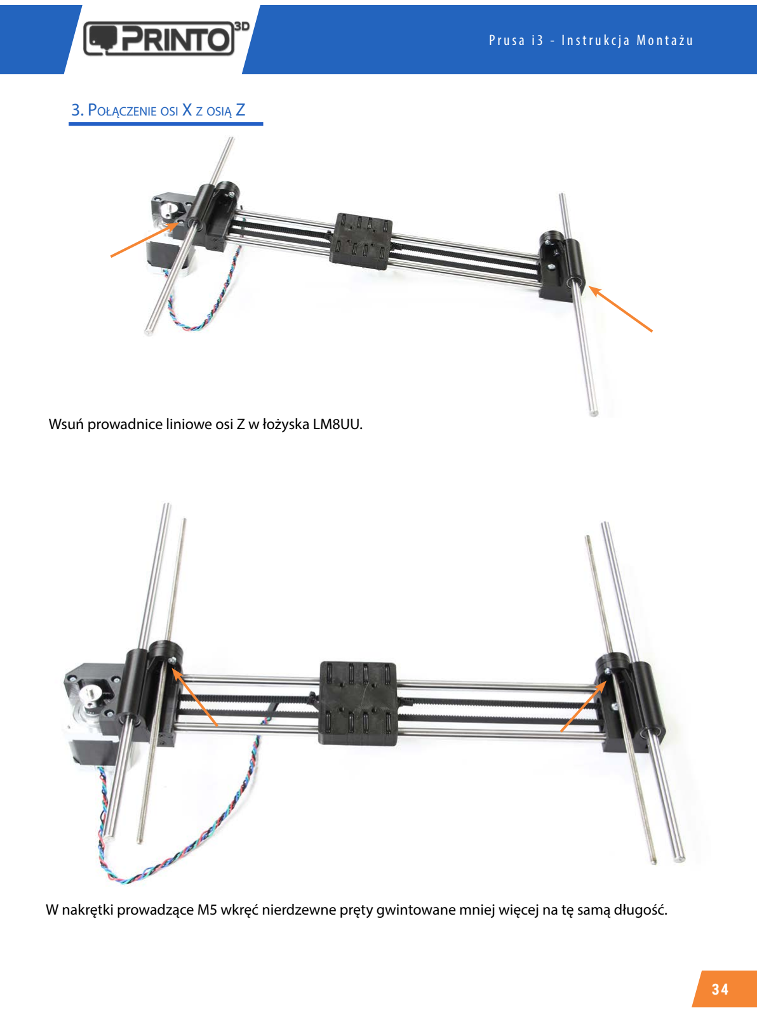
[picture p41: page 34]

34

3. Połączenie osi X z osią Z

W nakrętki prowadzące M5 wkręć nierdzewne pręty gwintowane mniej więcej na tę samą długość.

Wsuń prowadnice liniowe osi Z w łożyska LM8UU.

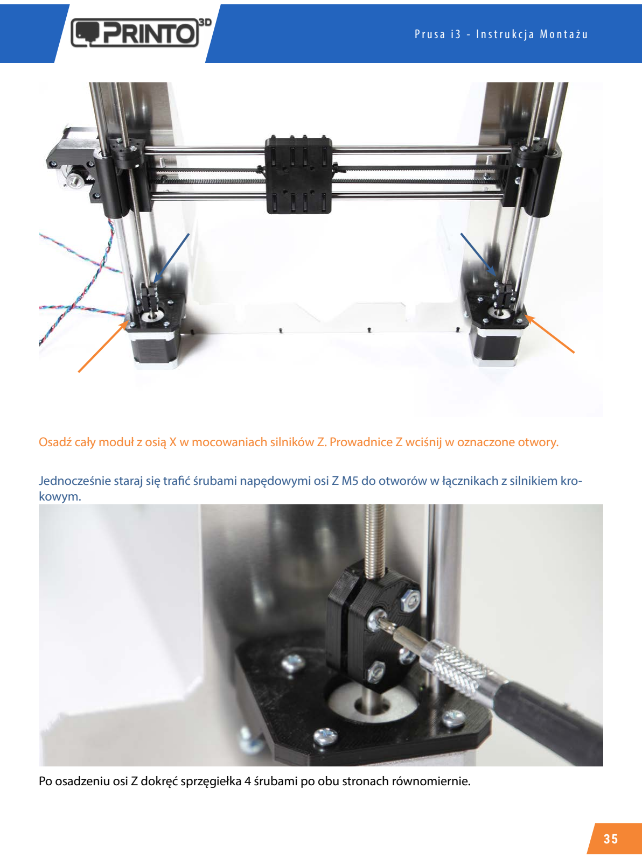
[picture p42: page 35]

35

Osadź cały moduł z osią X w mocowaniach silników Z. Prowadnice Z wciśnij w oznaczone otwory.

Jednocześnie staraj się trafić śrubami napędowymi osi Z M5 do otworów w łącznikach z silnikiem krokowym.

Po osadzeniu osi Z dokręć sprzęgiełka 4 śrubami po obu stronach równomiernie.

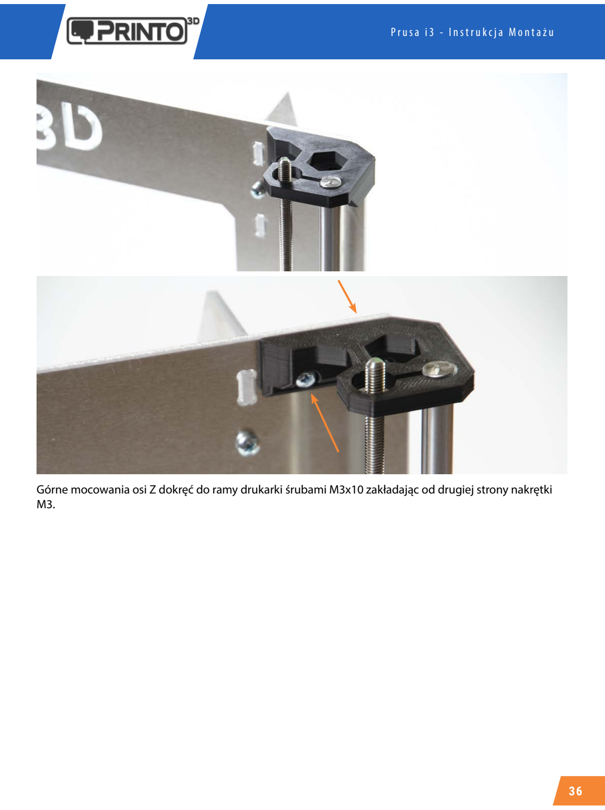
[picture p43: page 36]

36

Górne mocowania osi Z dokręć do ramy drukarki śrubami M3x10 zakładając od drugiej strony nakrętki M3.

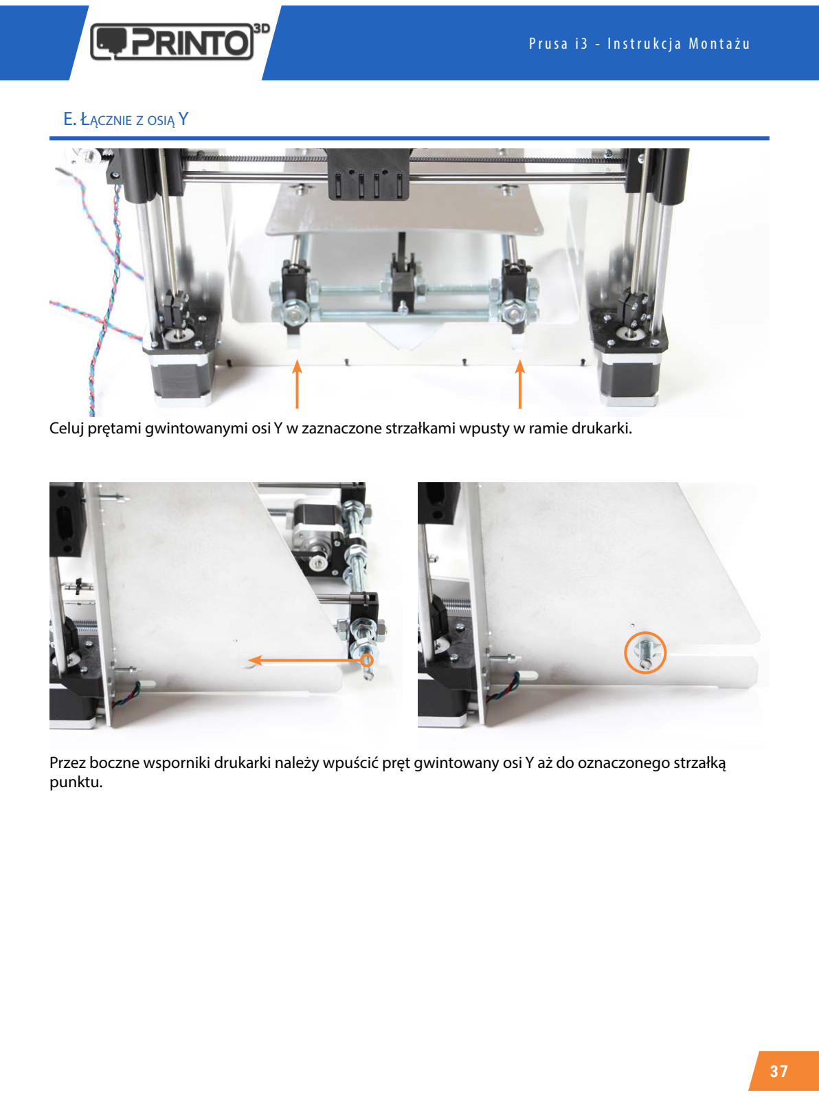
[picture p44: page 37]

37

E. Łącznie z osią Y

Celuj prętami gwintowanymi osi Y w zaznaczone strzałkami wpusty w ramie drukarki.

Przez boczne wsporniki drukarki należy wpuścić pręt gwintowany osi Y aż do oznaczonego strzałką punktu.

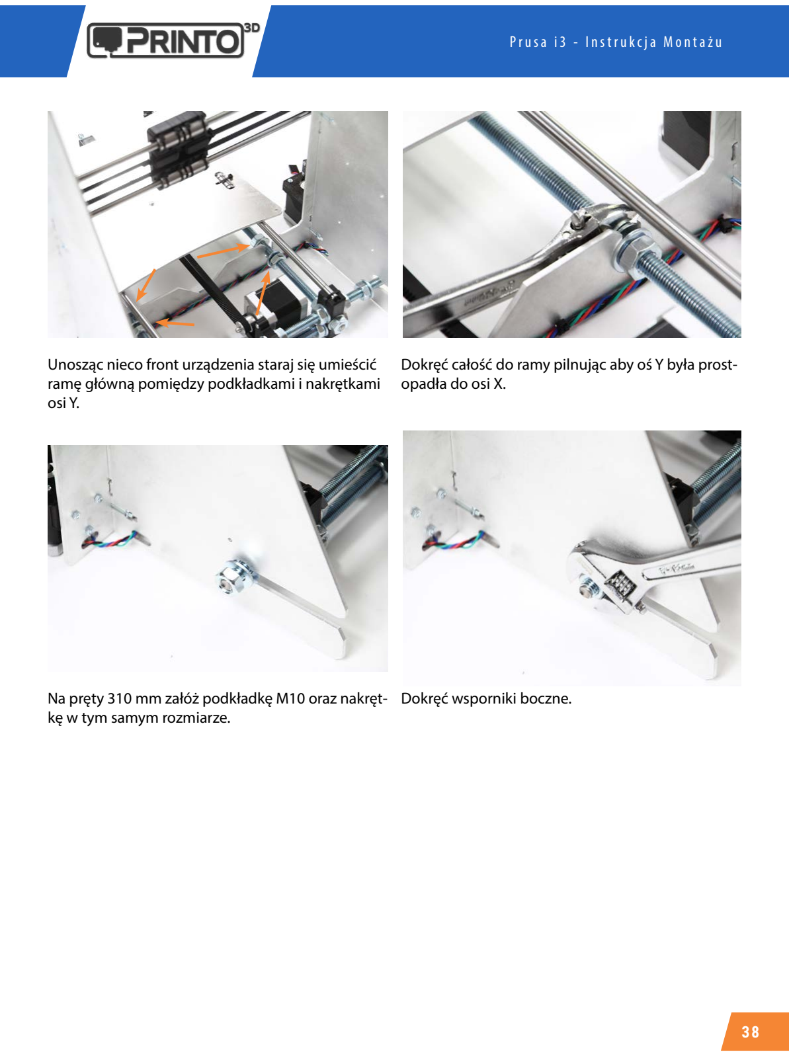
[picture p45: page 38]

38

Unosząc nieco front urządzenia staraj się umieścić ramę główną pomiędzy podkładkami i nakrętkami osi Y.

Dokręć całość do ramy pilnując aby oś Y była prostopadła do osi X.

Na pręty 310 mm załóż podkładkę M10 oraz nakrętkę w tym samym rozmiarze.

Dokręć wsporniki boczne.

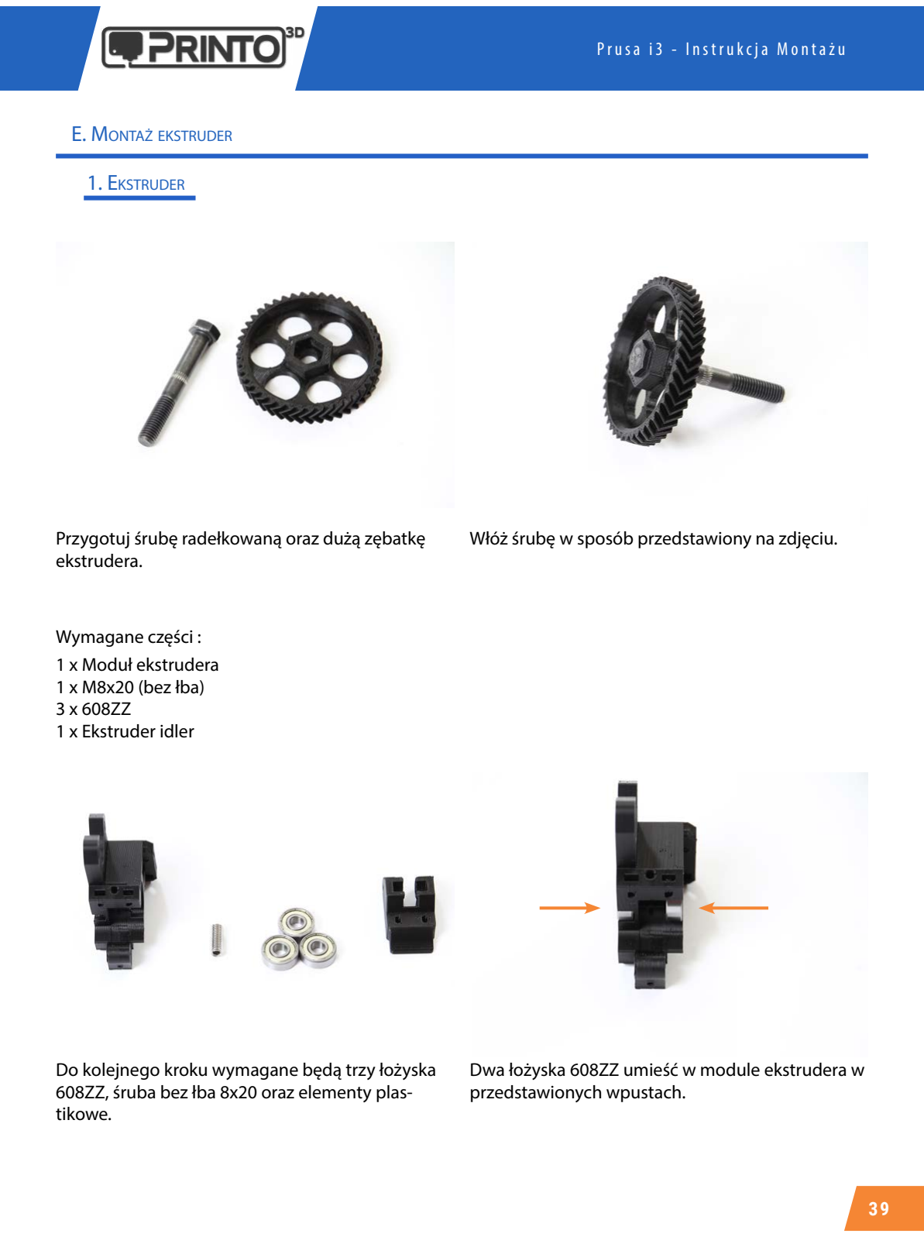
[picture p46: page 39]

39

E. Montaż ekstruder
1. Ekstruder

Przygotuj śrubę radełkowaną oraz dużą zębatkę ekstrudera.

Włóż śrubę w sposób przedstawiony na zdjęciu.

Wymagane części :
1 x Moduł ekstrudera
1 x M8x20 (bez łba)
3 x 608ZZ
1 x Ekstruder idler

Do kolejnego kroku wymagane będą trzy łożyska 608ZZ, śruba bez łba 8x20 oraz elementy plastikowe.

Dwa łożyska 608ZZ umieść w module ekstrudera w przedstawionych wpustach.

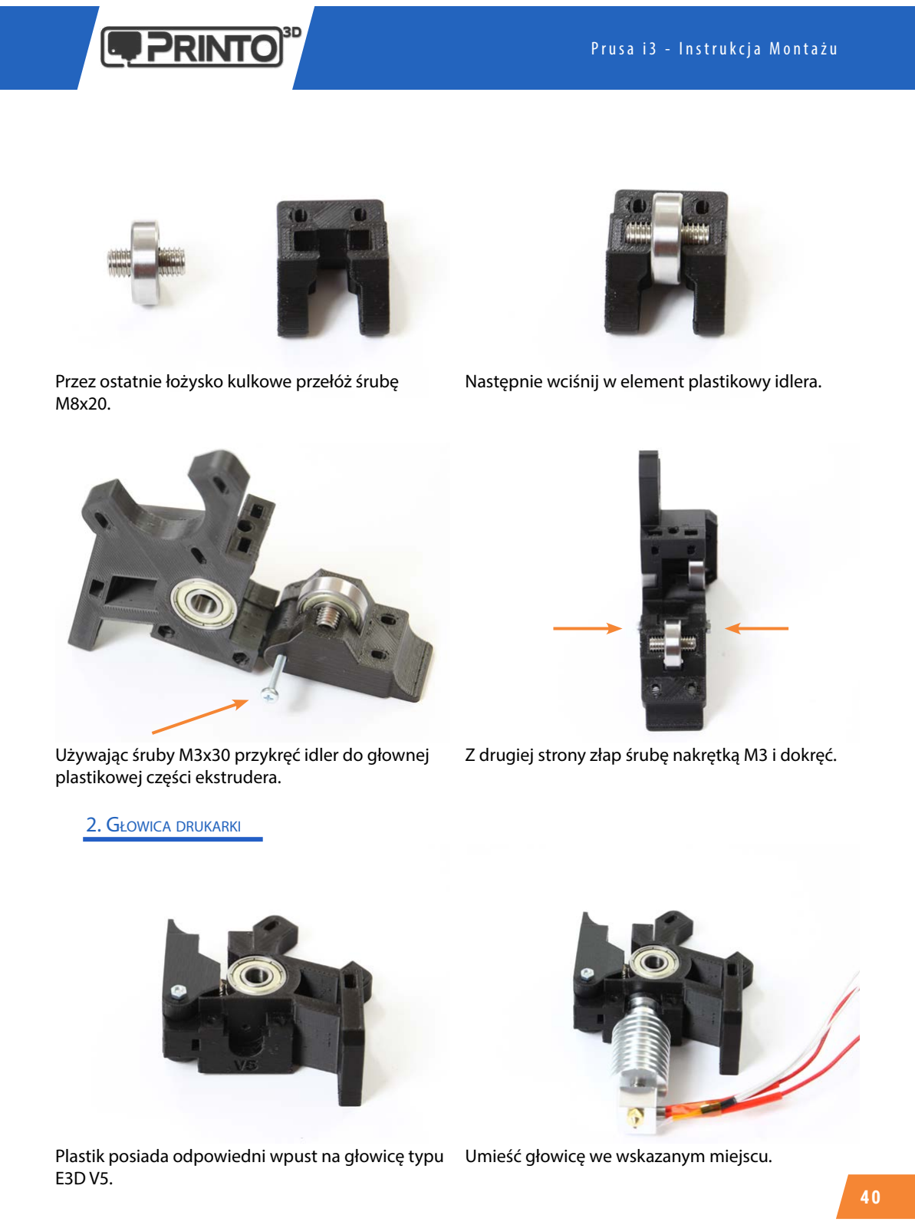
[picture p47: page 40]

40

Przez ostatnie łożysko kulkowe przełóż śrubę M8x20.

Następnie wciśnij w element plastikowy idlera.

Używając śruby M3x30 przykręć idler do głownej plastikowej części ekstrudera.

Z drugiej strony złap śrubę nakrętką M3 i dokręć.

2. Głowica drukarki

Plastik posiada odpowiedni wpust na głowicę typu E3D V5.

Umieść głowicę we wskazanym miejscu.

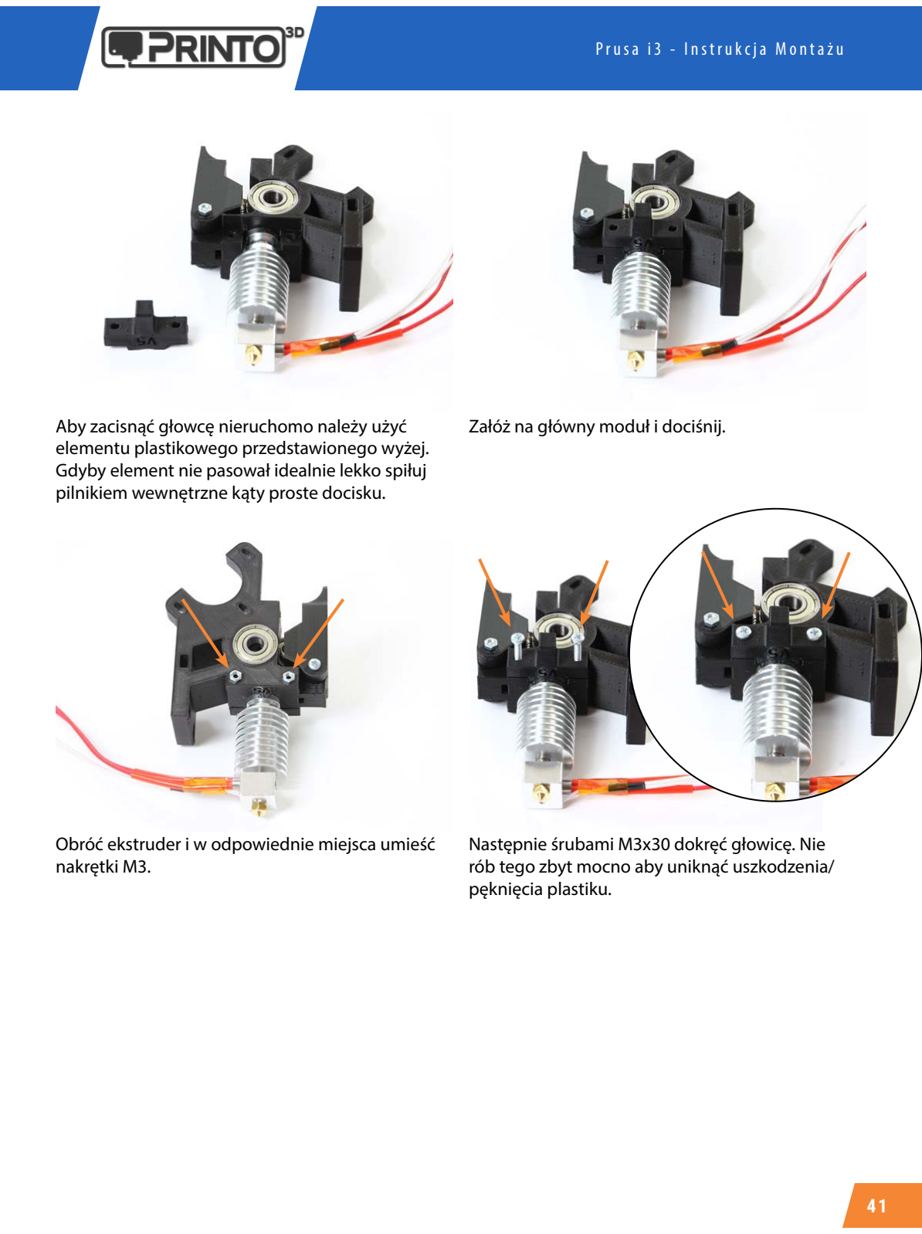
[picture p48: page 41]

41

Aby zacisnąć głowcę nieruchomo należy użyć elementu plastikowego przedstawionego wyżej. Gdyby element nie pasował idealnie lekko spiłuj pilnikiem wewnętrzne kąty proste docisku.

Załóż na główny moduł i dociśnij.

Obróć ekstruder i w odpowiednie miejsca umieść nakrętki M3.

Następnie śrubami M3x30 dokręć głowicę. Nie rób tego zbyt mocno aby uniknąć uszkodzenia/ pęknięcia plastiku.

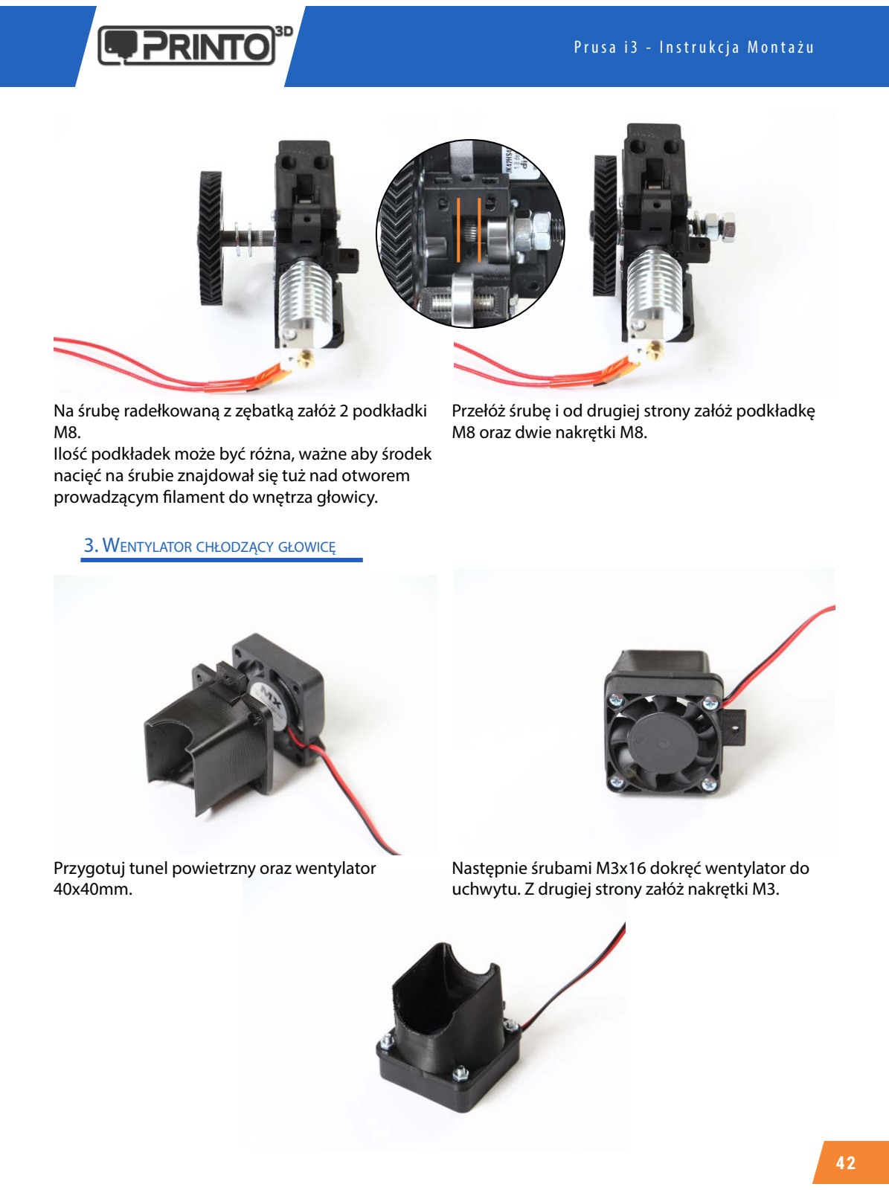
[picture p49: page 42]

42

Na śrubę radełkowaną z zębatką załóż 2 podkładki M8.
Ilość podkładek może być różna, ważne aby środek nacięć na śrubie znajdował się tuż nad otworem prowadzącym filament do wnętrza głowicy.

Przełóż śrubę i od drugiej strony załóż podkładkę M8 oraz dwie nakrętki M8.

3. Wentylator chłodzący głowicę

Przygotuj tunel powietrzny oraz wentylator 40x40mm.

Następnie śrubami M3x16 dokręć wentylator do uchwytu. Z drugiej strony załóż nakrętki M3.

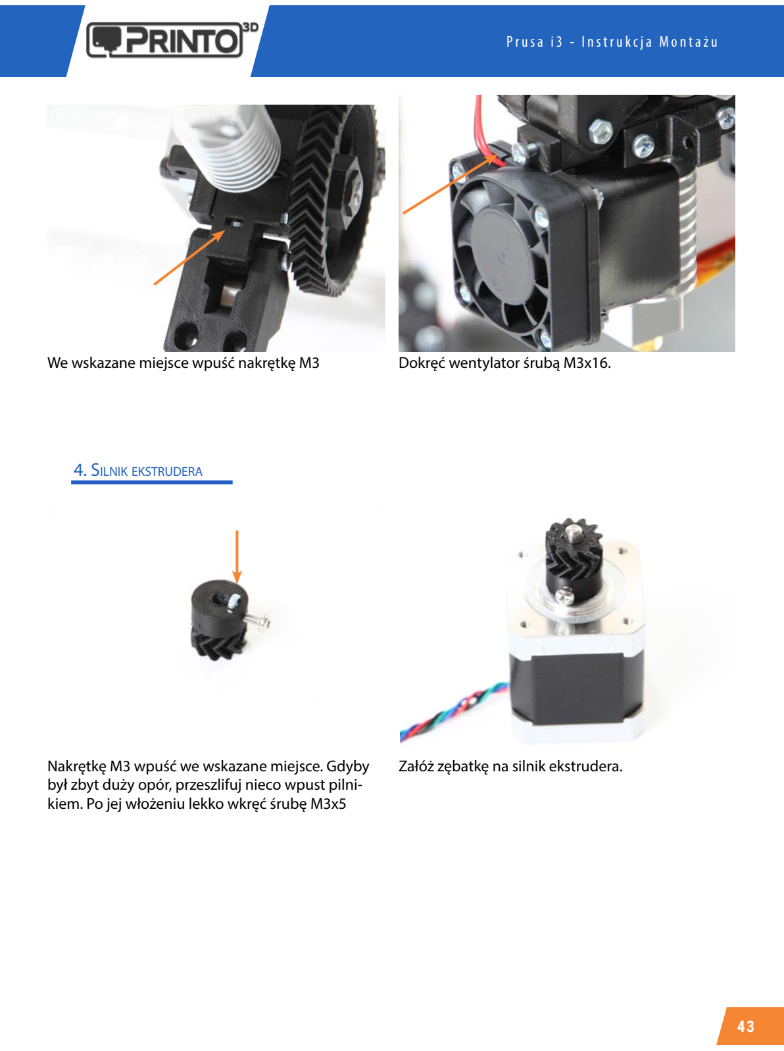
[picture p50: page 43]

43

We wskazane miejsce wpuść nakrętkę M3 | Dokręć wentylator śrubą M3x16.
4. Silnik ekstrudera

Nakrętkę M3 wpuść we wskazane miejsce. Gdyby był zbyt duży opór, przeszlifuj nieco wpust pilnikiem. Po jej włożeniu lekko wkręć śrubę M3x5

Załóż zębatkę na silnik ekstrudera.

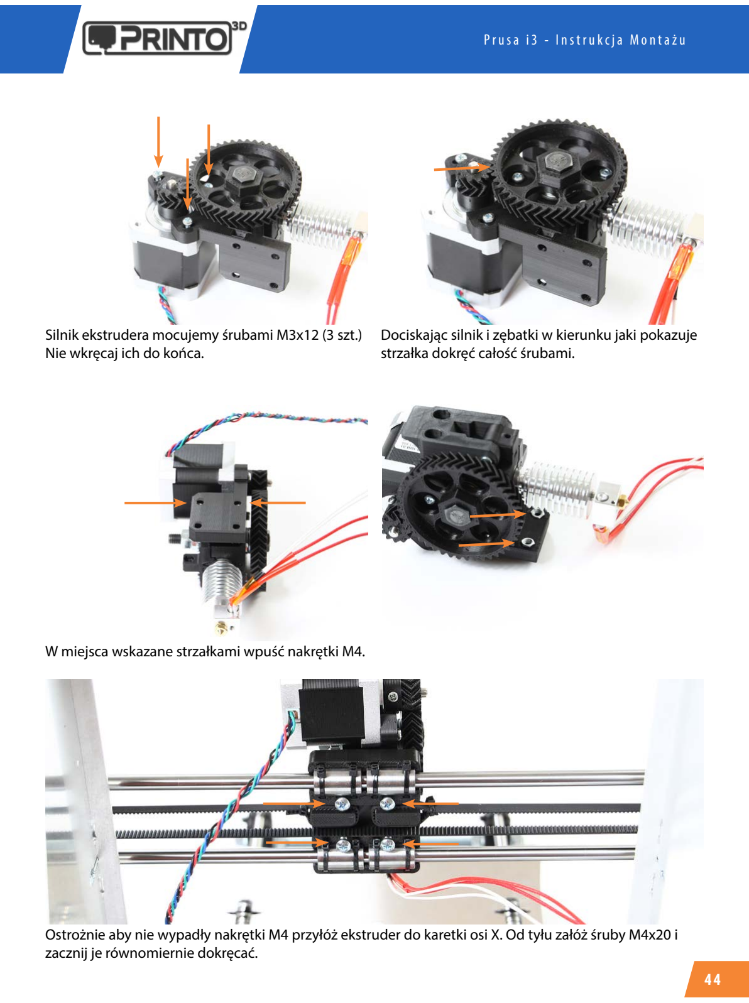
[picture p51: page 44]

44

Silnik ekstrudera mocujemy śrubami M3x12 (3 szt.) Nie wkręcaj ich do końca.

Dociskając silnik i zębatki w kierunku jaki pokazuje strzałka dokręć całość śrubami.

W miejsca wskazane strzałkami wpuść nakrętki M4.

Ostrożnie aby nie wypadły nakrętki M4 przyłóż ekstruder do karetki osi X. Od tyłu załóż śruby M4x20 i zacznij je równomiernie dokręcać.

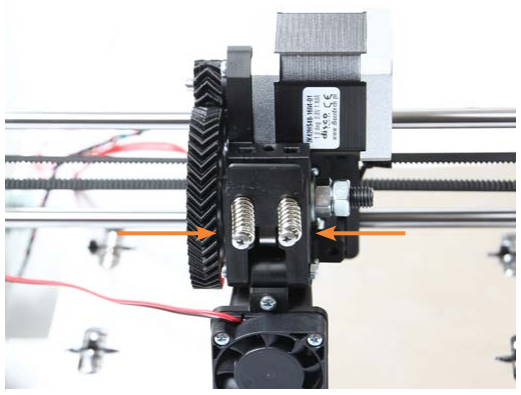
[picture p52: figure]

45

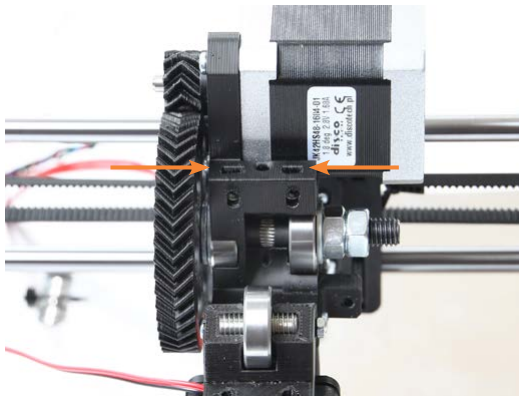
[picture p53: figure]

W ekstruder wpuść 2 nakrętki M3. | Następnie na dwie śruby M3x50 załóż sprężyny ek- strudera, i lekko dokręć idler do wcześniej wpuszc- zonych nakrętek.

46

# V Elektronika

## V. Elektronika

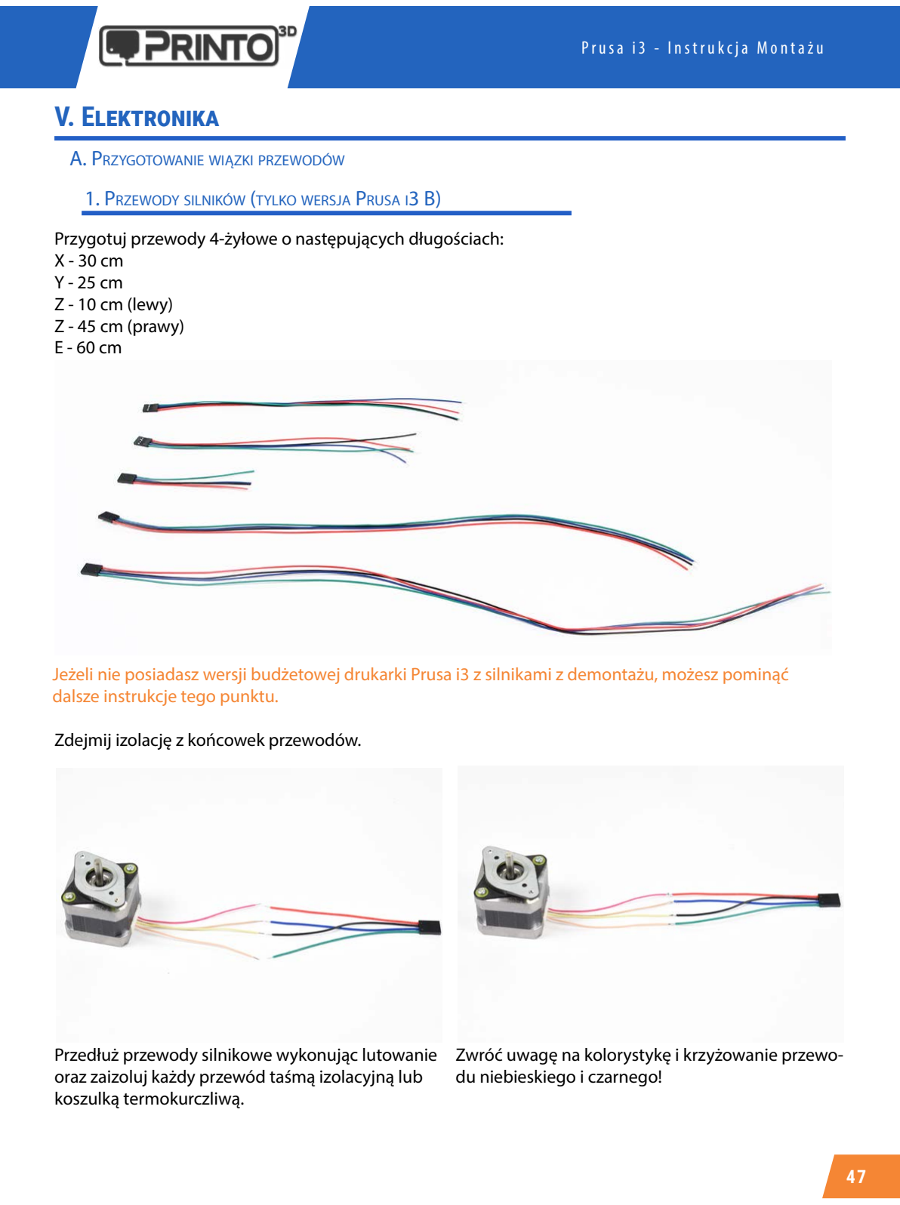
[picture p54: page 47]

47

A. Przygotowanie wiązki przewodów
1. Przewody silników (tylko wersja Prusa i3 B)

Jeżeli nie posiadasz wersji budżetowej drukarki Prusa i3 z silnikami z demontażu, możesz pominąć dalsze instrukcje tego punktu.

Przygotuj przewody 4-żyłowe o następujących długościach: X - 30 cm
Y - 25 cm
Z - 10 cm (lewy)
Z - 45 cm (prawy)
E - 60 cm

Zdejmij izolację z końcowek przewodów.

Przedłuż przewody silnikowe wykonując lutowanie oraz zaizoluj każdy przewód taśmą izolacyjną lub koszulką termokurczliwą.

Zwróć uwagę na kolorystykę i krzyżowanie przewodu niebieskiego i czarnego!

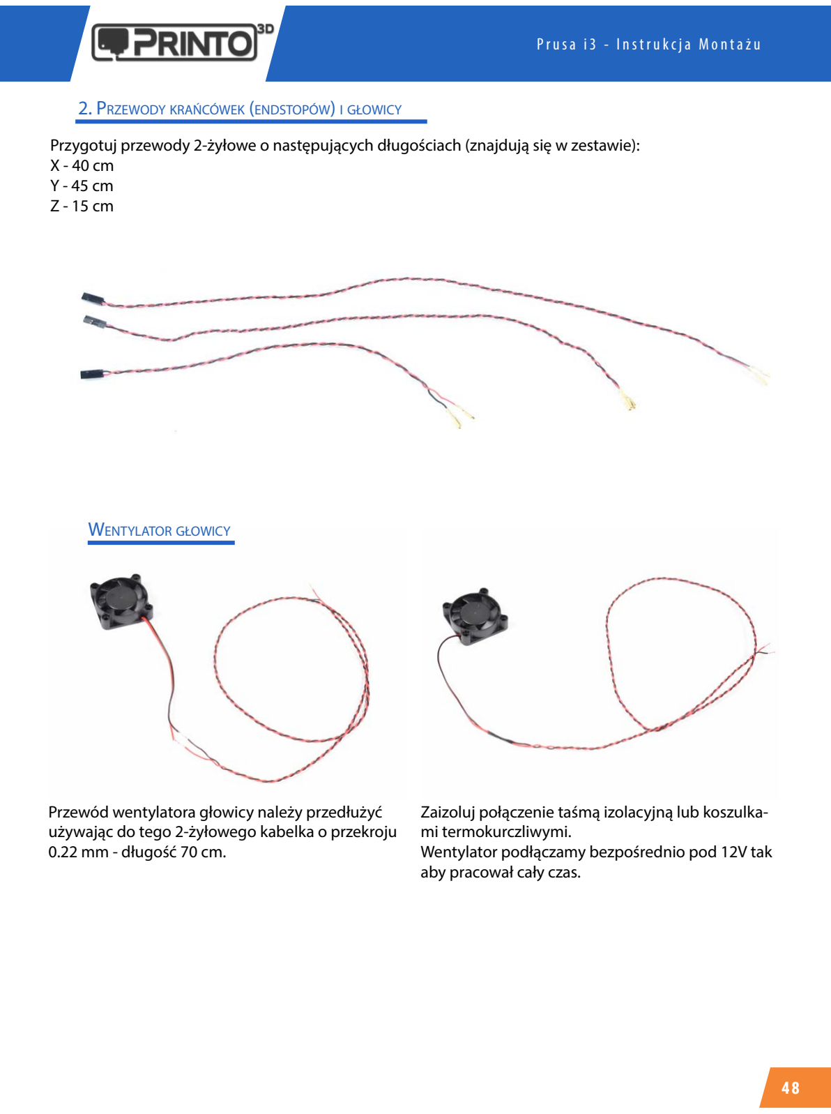
[picture p55: page 48]

48

2. Przewody krańcówek (endstopów) i głowicy

Przygotuj przewody 2-żyłowe o następujących długościach (znajdują się w zestawie): X - 40 cm
Y - 45 cm
Z - 15 cm

Przewód wentylatora głowicy należy przedłużyć używając do tego 2-żyłowego kabelka o przekroju 0.22 mm - długość 70 cm.

Zaizoluj połączenie taśmą izolacyjną lub koszulkami termokurczliwymi.
Wentylator podłączamy bezpośrednio pod 12V tak aby pracował cały czas.

Wentylator głowicy

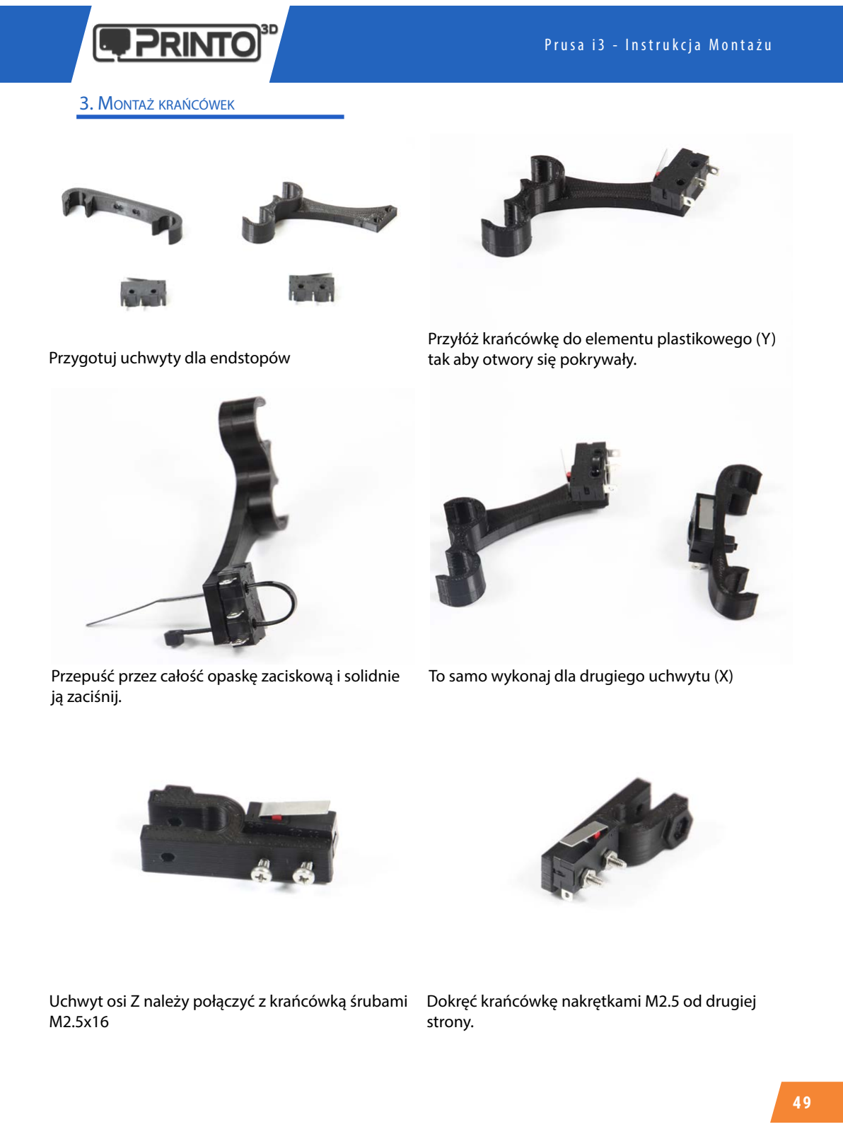
[picture p56: page 49]

49

Przygotuj uchwyty dla endstopów

Przyłóż krańcówkę do elementu plastikowego (Y) tak aby otwory się pokrywały.

Przepuść przez całość opaskę zaciskową i solidnie ją zaciśnij.

To samo wykonaj dla drugiego uchwytu (X)

3. Montaż krańcówek

Uchwyt osi Z należy połączyć z krańcówką śrubami M2.5x16

Dokręć krańcówkę nakrętkami M2.5 od drugiej strony.

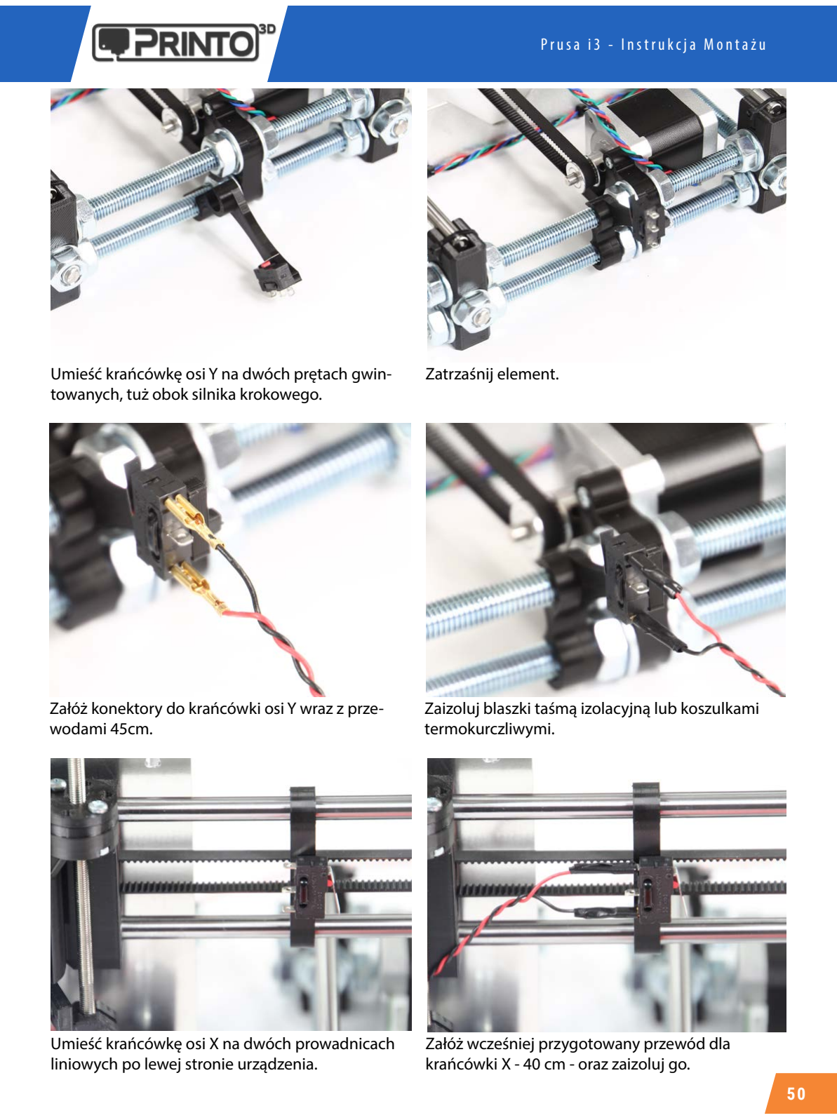
[picture p57: page 50]

50

Umieść krańcówkę osi Y na dwóch prętach gwintowanych, tuż obok silnika krokowego.

Zatrzaśnij element.

Umieść krańcówkę osi X na dwóch prowadnicach liniowych po lewej stronie urządzenia.

Załóż wcześniej przygotowany przewód dla krańcówki X - 40 cm - oraz zaizoluj go.

Załóż konektory do krańcówki osi Y wraz z przewodami 45cm.

Zaizoluj blaszki taśmą izolacyjną lub koszulkami termokurczliwymi.

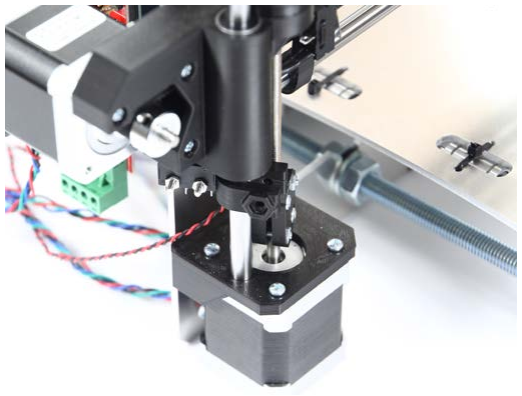
[picture p58: figure]

51

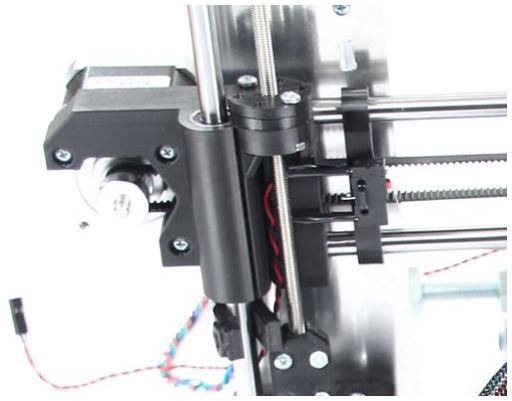
[picture p59: figure]

Dosuń krańcówkę X do lewej strony urządzenia tak jak na fotografii.

Umieść krańcówkę osi Z na dolnej części prowadnicy 8 mm tuż pod elementem X-end-motor. Endstop umieść w taki sposób aby przy załączeniu/ kliknięciu głowica nie kolidowała o stolik grzewczy.

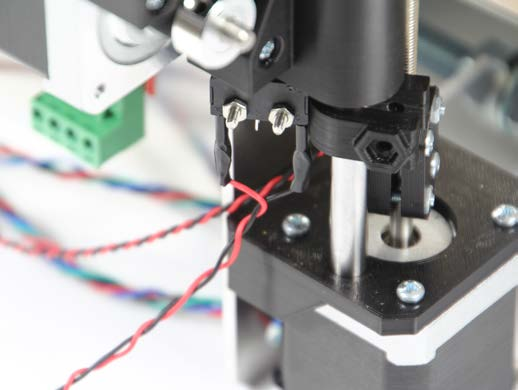
[picture p60: figure]

Podłącz przewody do krańcówki - 15 cm i owiń izolacją.

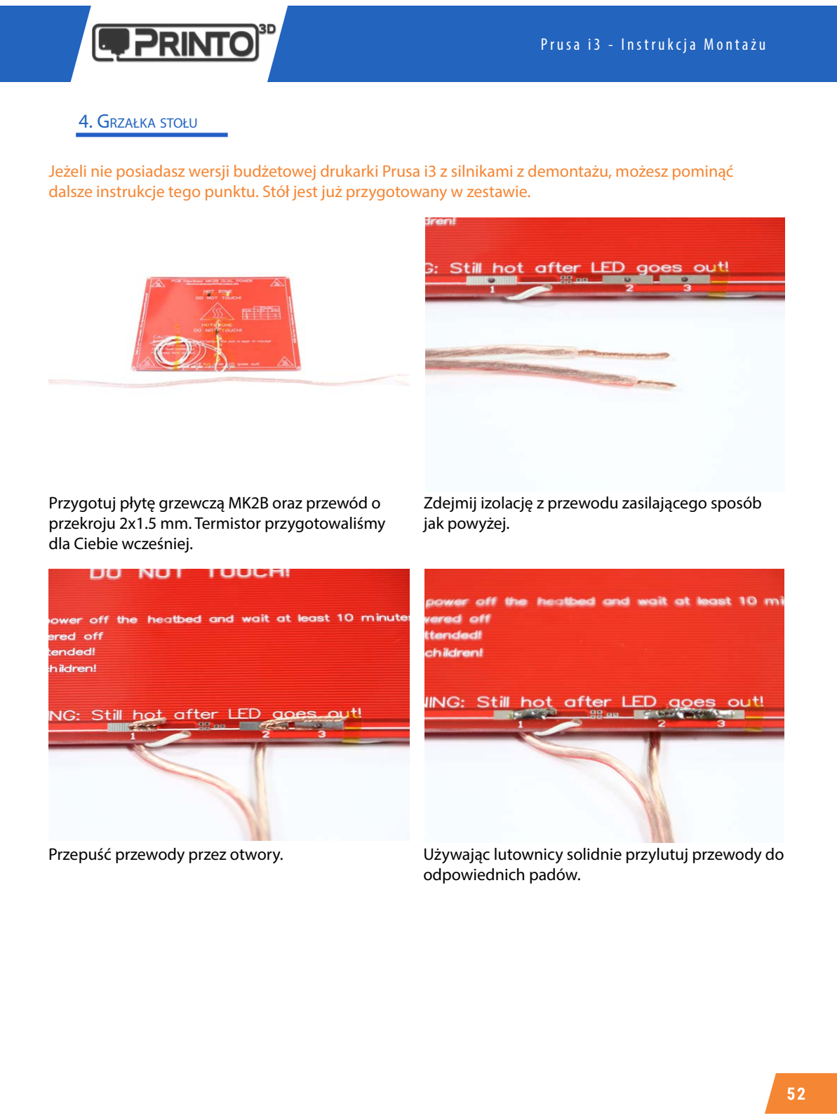
[picture p61: page 52]

52

4. Grzałka stołu

Przygotuj płytę grzewczą MK2B oraz przewód o przekroju 2x1.5 mm. Termistor przygotowaliśmy dla Ciebie wcześniej.

Zdejmij izolację z przewodu zasilającego sposób jak powyżej.

Przepuść przewody przez otwory. | Używając lutownicy solidnie przylutuj przewody do odpowiednich padów.

Jeżeli nie posiadasz wersji budżetowej drukarki Prusa i3 z silnikami z demontażu, możesz pominąć dalsze instrukcje tego punktu. Stół jest już przygotowany w zestawie.

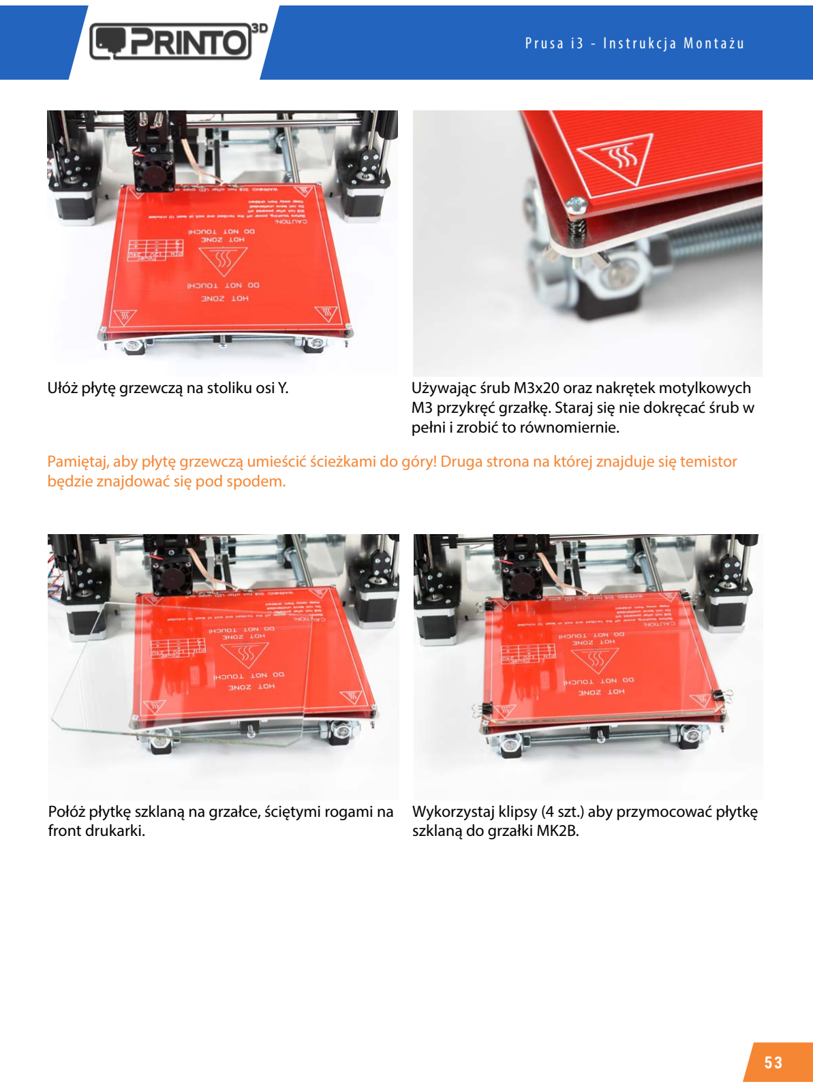
[picture p62: page 53]

53

Ułóż płytę grzewczą na stoliku osi Y. | Używając śrub M3x20 oraz nakrętek motylkowych M3 przykręć grzałkę. Staraj się nie dokręcać śrub w pełni i zrobić to równomiernie.

Pamiętaj, aby płytę grzewczą umieścić ścieżkami do góry! Druga strona na której znajduje się temistor będzie znajdować się pod spodem.

Połóż płytkę szklaną na grzałce, ściętymi rogami na front drukarki.

Wykorzystaj klipsy (4 szt.) aby przymocować płytkę szklaną do grzałki MK2B.

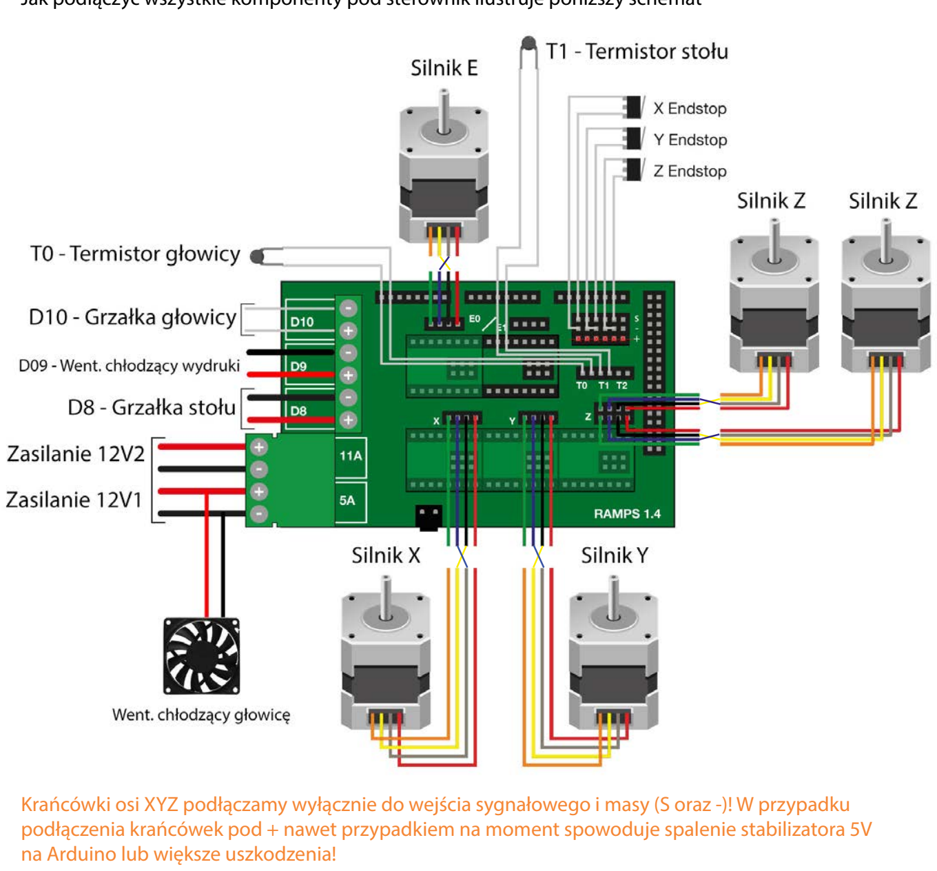
[picture p63: figure]
na Arduino lub większe uszkodzenia!

54

Jak podłączyć wszystkie komponenty pod sterownik ilustruje poniższy schemat

Silniki krokowe NEMA 17 mogą posiadać różnego koloru wyprowadzenia w zależności od producenta. Nawet w przypadku złego podłączenia nie ma obawy, że cokolwiek ulegnie spaleniu. Jedyne co może się stać to dziwne zachowanie silnika. Jak dokładnie rozpoznać wyprowadzenia silnika w razie braku schematu opisujemy na naszej stronie internetowej:

http://www.printo3d.pl/sprawdzic-wyprowadzenia-silnika-krokowego/http://www.printo3d.pl/podlaczanie-silnika-krokowego/

Krańcówki osi XYZ podłączamy wyłącznie do wejścia sygnałowego i masy (S oraz -)! W przypadku podłączenia krańcówek pod + nawet przypadkiem na moment spowoduje spalenie stabilizatora 5V

5. Schemat połączeń

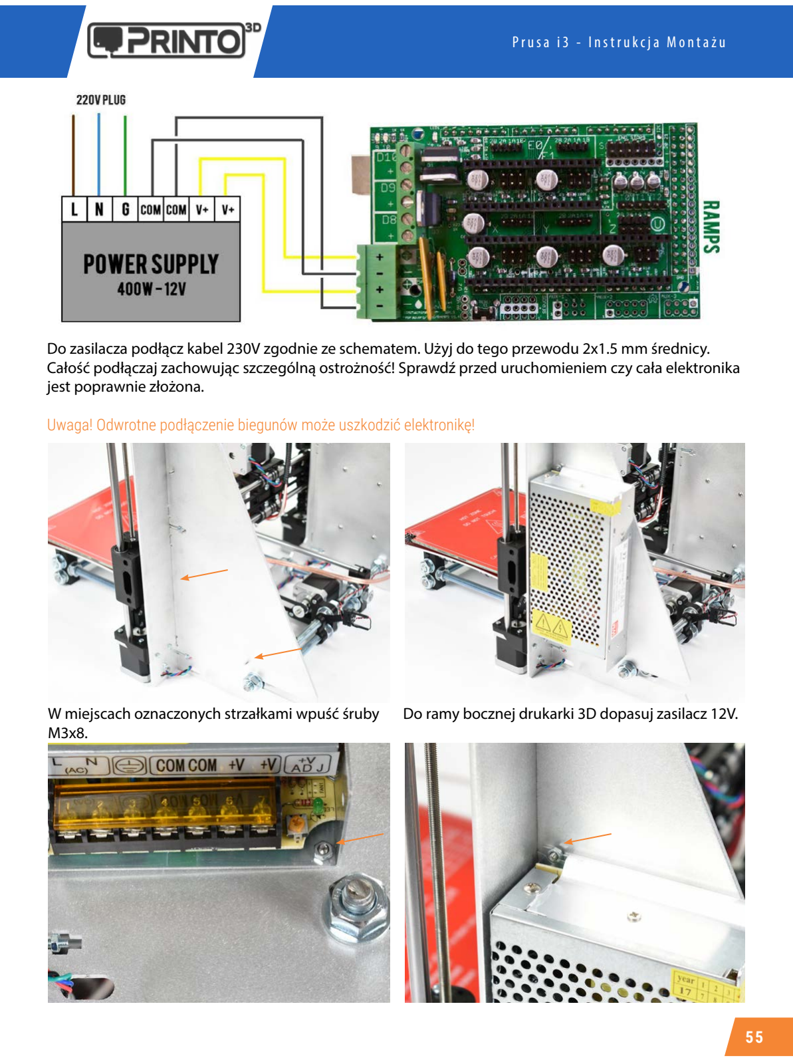
[picture p64: page 55]

55

Do zasilacza podłącz kabel 230V zgodnie ze schematem. Użyj do tego przewodu 2x1.5 mm średnicy. Całość podłączaj zachowując szczególną ostrożność! Sprawdź przed uruchomieniem czy cała elektronika jest poprawnie złożona.
Uwaga! Odwrotne podłączenie biegunów może uszkodzić elektronikę!

W miejscach oznaczonych strzałkami wpuść śruby M3x8.

Do ramy bocznej drukarki 3D dopasuj zasilacz 12V.

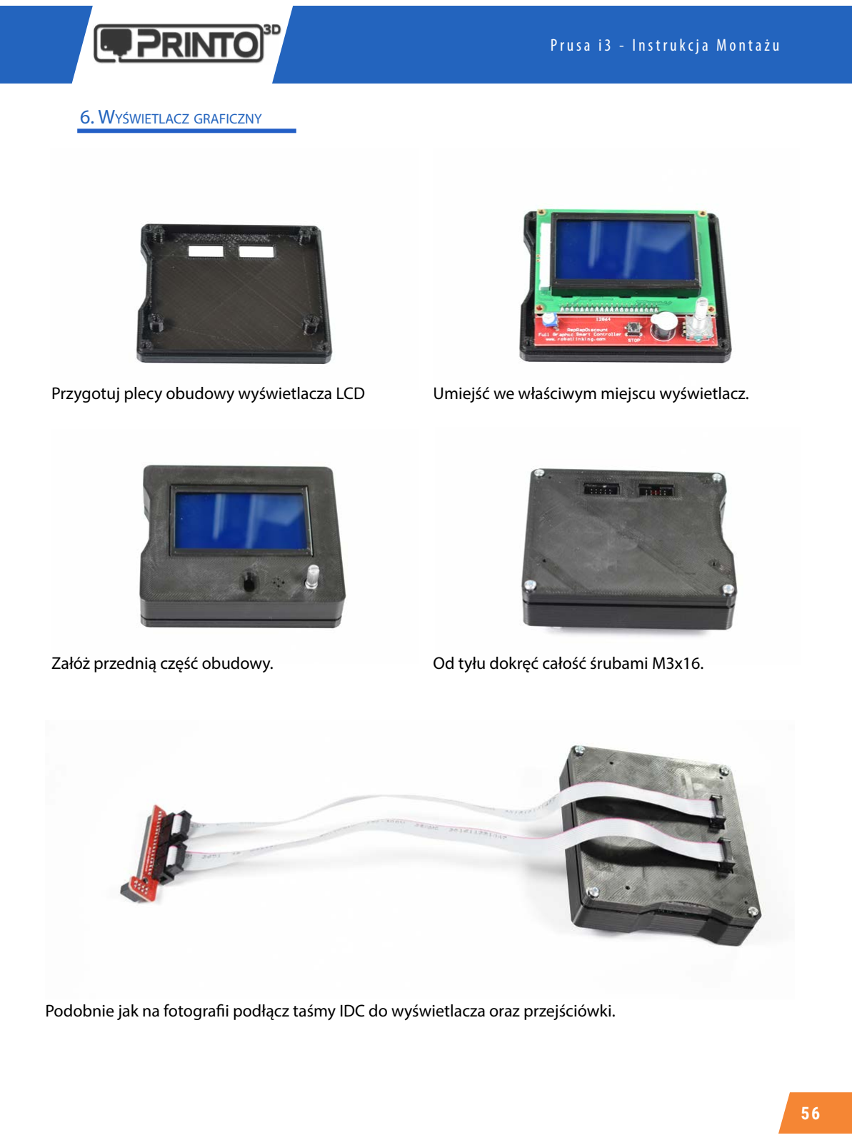
[picture p65: page 56]

56

6. Wyświetlacz graficzny
Przygotuj plecy obudowy wyświetlacza LCD | Umiejść we właściwym miejscu wyświetlacz.
Załóż przednią część obudowy. | Od tyłu dokręć całość śrubami M3x16.

Podobnie jak na fotografii podłącz taśmy IDC do wyświetlacza oraz przejściówki.

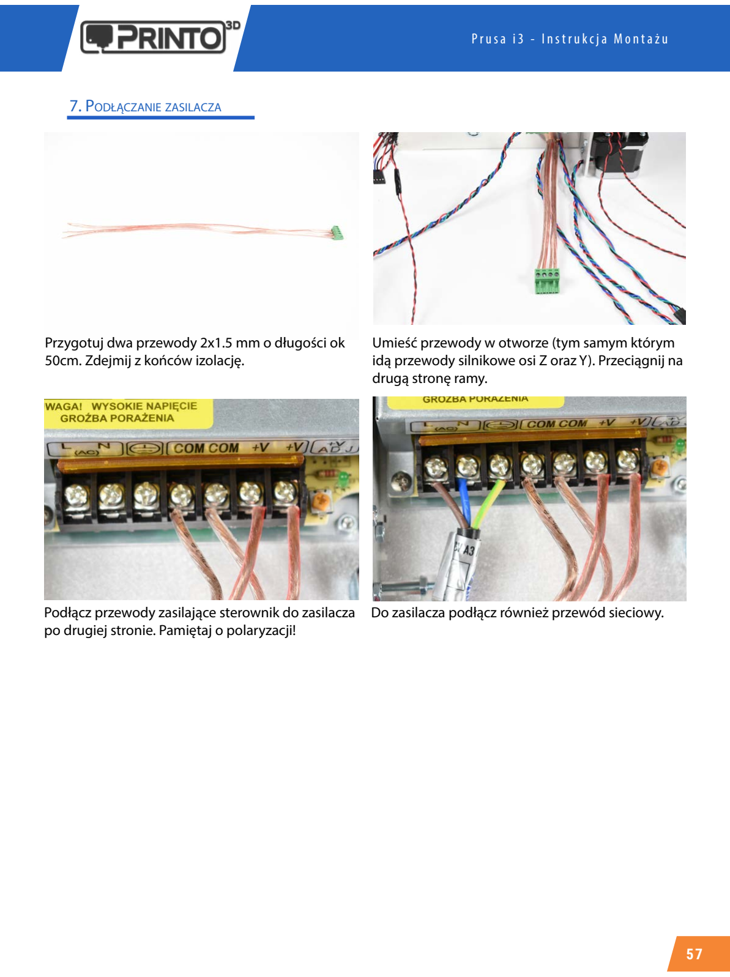
[picture p66: page 57]

57

7. Podłączanie zasilacza

Przygotuj dwa przewody 2x1.5 mm o długości ok 50cm. Zdejmij z końców izolację.

Umieść przewody w otworze (tym samym którym idą przewody silnikowe osi Z oraz Y). Przeciągnij na drugą stronę ramy.

Podłącz przewody zasilające sterownik do zasilacza po drugiej stronie. Pamiętaj o polaryzacji!

Do zasilacza podłącz również przewód sieciowy.

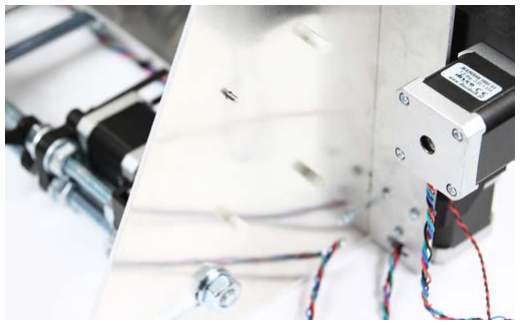
[picture p67: figure]

58

8. Sterownik

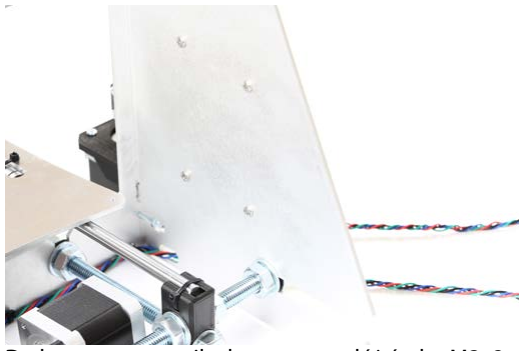
[picture p68: figure]

Do lewego wspornika bocznego załóż śruby M3x8 w odpowiednie otwory.

Po przeciwnej stronie wkręć gwintowane tulejki dystansowe M3.

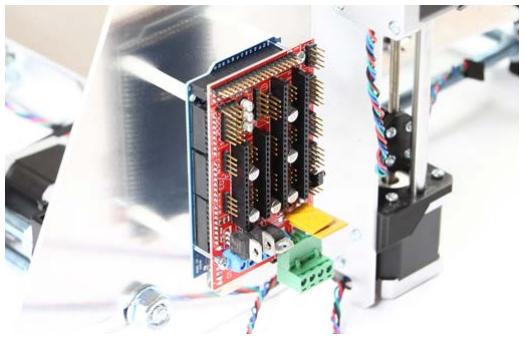
[picture p69: figure]

Do wcześniej wkręconych dystansów przykręć sterownik Arduino+Ramps.

59

# Przygotowanie Do Pracy V

60

A. Wgrywanie Firmware

Drukarka 3D Prusa i3 to projekt bazujący na otwartym oprogramowaniu, oraz rozwiązaniach tzw. OpenHardware. W związku z tym ostateczny wybór firmware’u na którym będzie pracować urządzenie należy do użytkownika i jego preferencji. Z reguły wspieramy firmware Marlin i na nim pracuje większość naszych drukarek, nic jednak nie stoi na przeszkodzie aby wykorzystać np. firmware Repetier.

1.

## V. Przygotowanie Do Pracy

Aby ożywić drukarkę należy wgrać do mikrokontrolera oprogramowanie sterujące korzystając z kabla USB A->B.

Pobieramy oraz instalujemy środowisko uruchomieniowe IDE Arduino ze strony projektu:

https://www.arduino.cc/en/Main/Software
Następnie pobieramy wstępnie przygotowany firmware z naszej strony internetowej (dział download->firmware):

http://www.printo3d.pl/

2.

Wykorzystanie wyświetlacza graficznego 128x64 wymaga użycia biblioteki u8glib. Pobieramy ją na:
https://code.google.com/p/u8glib/wiki/u8glib

3.

Po pobraniu wszystkich niezbędnych elementów otwieramy środowisko Arduino oraz odpalamy główny plik projektu firmware do drukarki Prusa i3 (Marlin.ino).

W środowisku Arduino importujemy u8glib poprzez menu Szkic->Importuj bibliotekę->Dodaj bibliotekę... oraz wskazujemy plik .zip z biblioteką.

Z menu Narzędzia wybieramy właściwą płytę (Arduino Mega) oraz procesor (ATMega 2560). Po podłączeniu kablem USB A->B naszego sterownika Arduino wybieramy dodatkowo port na którym widoczny jest kontroler.

Teraz wystarczy skompilować program oraz wgrać na płytkę.

4.

61

B. Poziomowanie Stołu

Regulacja wysokości musi być wykonana każdorazowo przy zmianie głowicy lub dyszy. Najlepiej przeprowadzić ją przy rozgrzanej głowicy i stole. Lecz za pierwszym razem wykonaj ją “na zimno” aby uniknąć kolizji przy pierwszym uruchomieniu drukarki 3D.

### 1. Na stole osi Z zamocowana jest regulacja śrubą M3x35 położenia stołu względem

głowicy. Kręcąc śrubą w lewo lub prawo należy tak dopasować wysokość stolika aby przy załączeniu się krańcówki (słysząc jej kliknięcie) stolik znajdował się na wysokości dyszy głowicy drukującej (tak by między stołem a dyszą zmieściła się kartka papieru).

Ustalanie pozycji bazowej stołu Z nie musi być bardzo dokładne, ew nierówności rzędu 1-2 mm będzie można nadrobić 4 śrubami poziomującymi stolik roboczy.

### 2. Po wstępnym ustaleniu pozycji bazowych osi, uruchom drukarkę i wykonaj bazowanie

(Menu->Przygotuj->Auto HOME lub Bazowanie Osi). Gdyby było to konieczne powtórz krok 1.
Następnie rozgrzej głowicę i stół to temperatur roboczych dla używanego typu plastiku.

### 3. Po automatycznym bazowaniu osi można przystąpić do dokładnego poziomowania

stolika roboczego. Weź kartkę papieru i złóż ją na pół. W czterech punktach, tam gdzie znajdują się śruby mocujące stolik wyreguluj jego wysokość tak aby kartka przesuwała się pomiędzy dyszą a stołem ze średnim oporem.

Po wykonaniu tej czynności zbazuj urządzenie jeszcze raz i sprawdz poprawność poziomowania. Drukarka jest gotowa do pracy.
