printo3d/Prusai3-Rework-Alu/Ramai3-Alu.dxf

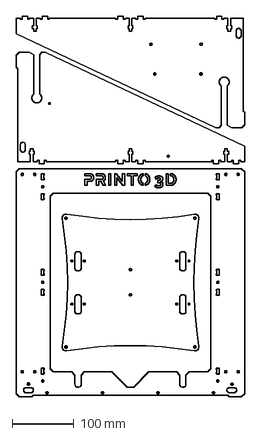
[picture p70: CAD file, 2021-11-24]
Ramai3-Alu.dxf
370.1 x 616.8 mm
