printo3d/Prusai3-Rework-Alu/STL/i3AL-Zbior2.stl

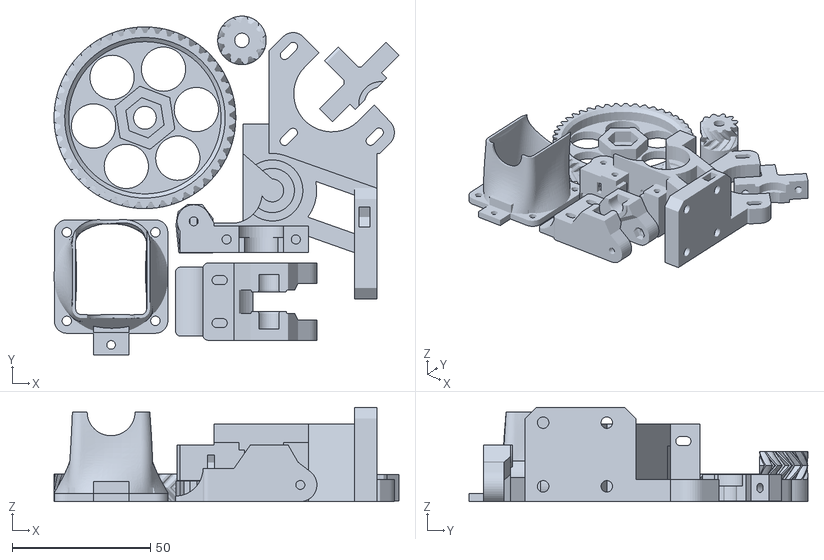
[picture p71: CAD file, 2021-11-24]
STL/i3AL-Zbior2.stl
124.6 x 122.4 x 34.0
