printo3d/Prusai3-Rework-Alu/STL/i3AL-Zbior1.stl

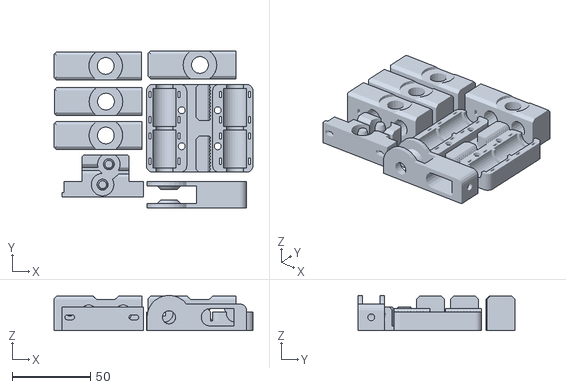
[picture p72: CAD file, 2021-11-24]
STL/i3AL-Zbior1.stl
127.0 x 100.4 x 22.5
