printo3d/Prusai3-Rework-Alu/STL/i3AL+-Zbior4.stl

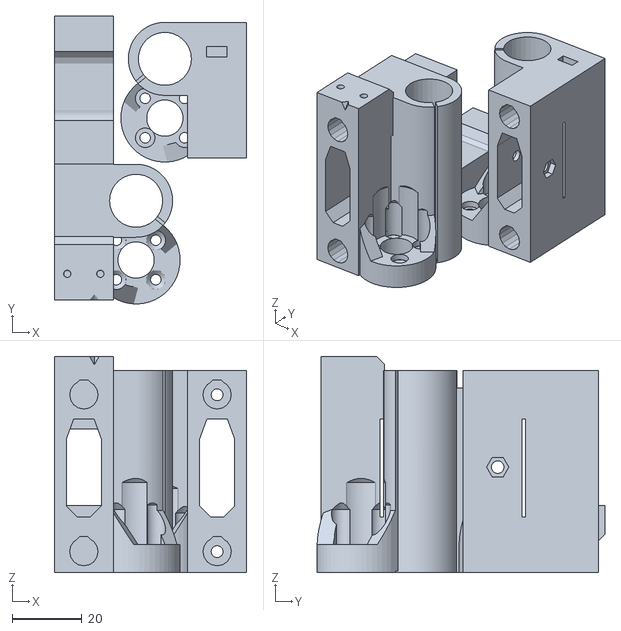
[picture p73: CAD file, 2021-11-24]
STL/i3AL+-Zbior4.stl
55.2 x 82.6 x 62.0
