printo3d/Prusai3-Rework-Alu/STL/i3AL-Zbior3.stl

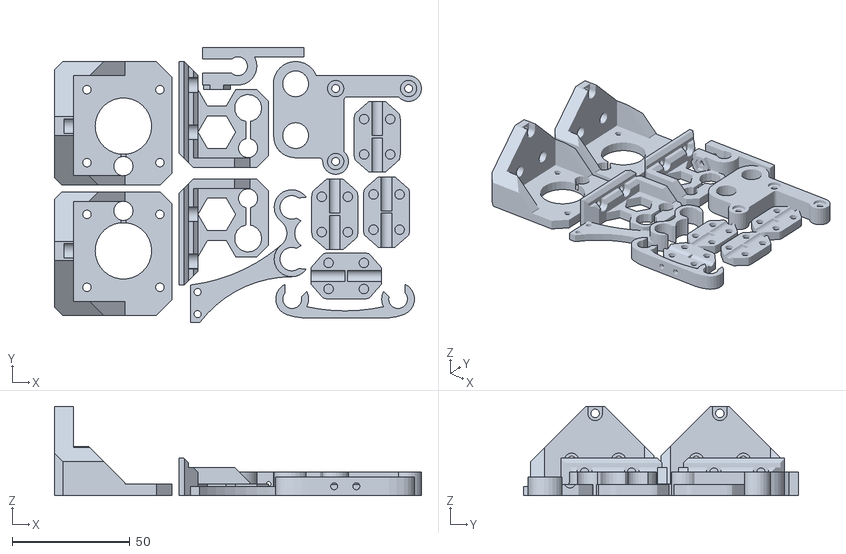
[picture p74: CAD file, 2021-11-24]
STL/i3AL-Zbior3.stl
156.0 x 117.0 x 38.0
