printo3d/Prusai3-Rework-Alu/(list of files, cad)

Other CAD files:
STL/i3AL-Zbior4.stl
